Bwooce/ZebSerialWifi/enclosure/renders/diode_iso.png

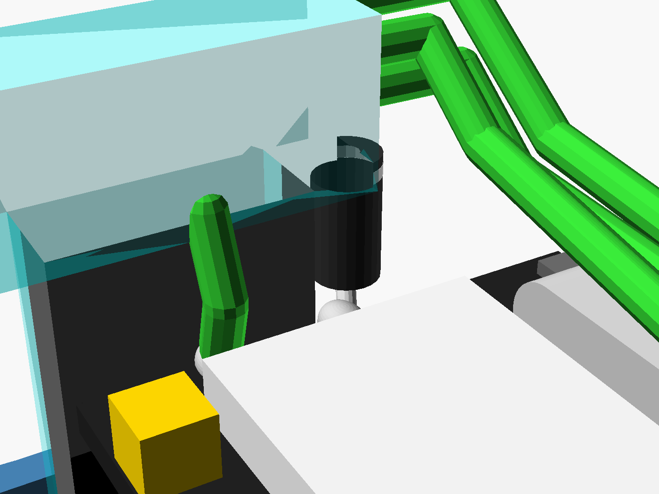
enclosure/renders/diode_iso.png
