Bwooce/ZebSerialWifi/enclosure/renders/exploded.png

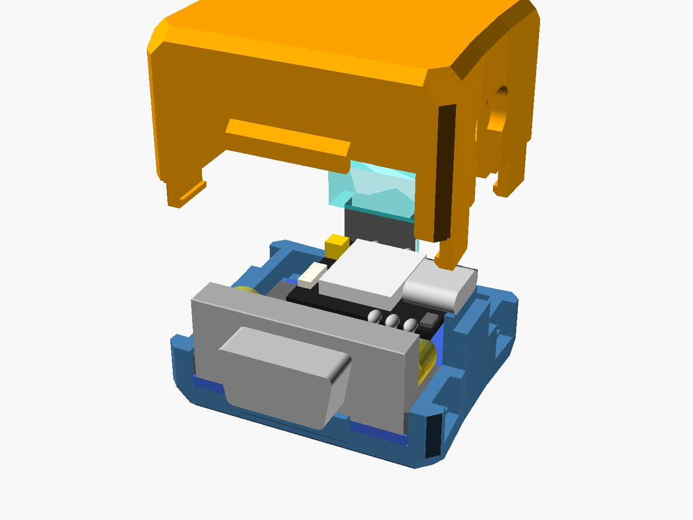
enclosure/renders/exploded.png
