Bwooce/ZebSerialWifi/enclosure/renders/front_elevation.png

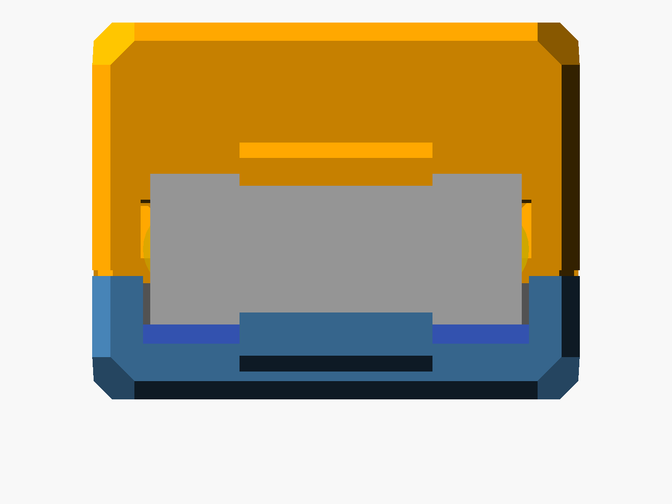
enclosure/renders/front_elevation.png
