Bwooce/ZebSerialWifi/enclosure/renders/front_flush.png

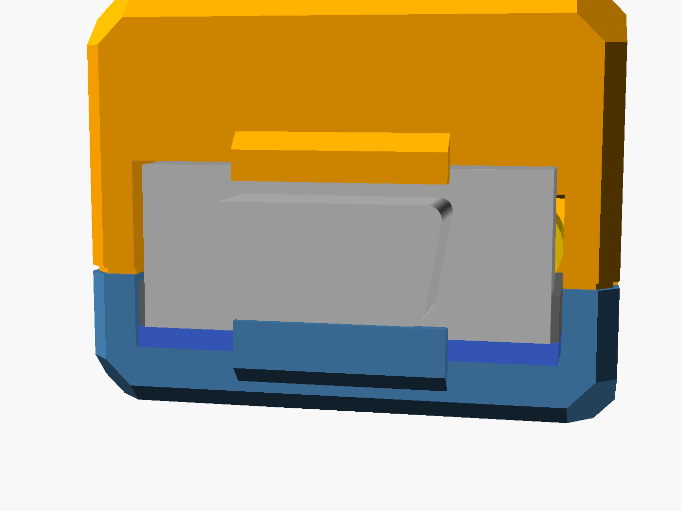
enclosure/renders/front_flush.png
