Bwooce/ZebSerialWifi/enclosure/renders/lid_front.png

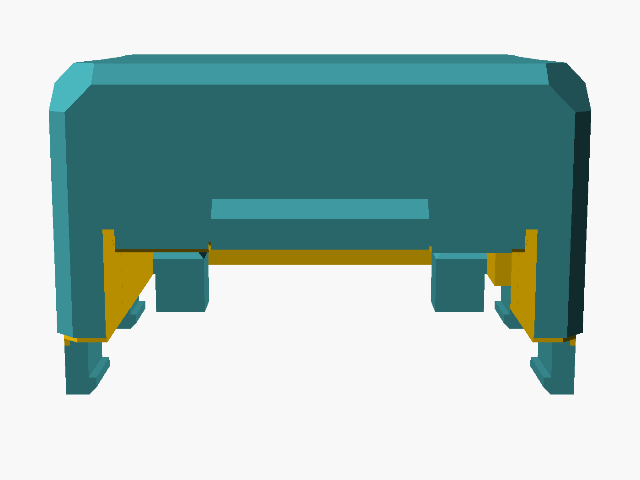
enclosure/renders/lid_front.png
