Bwooce/ZebSerialWifi/enclosure/renders/plugged_floor_deboss.png

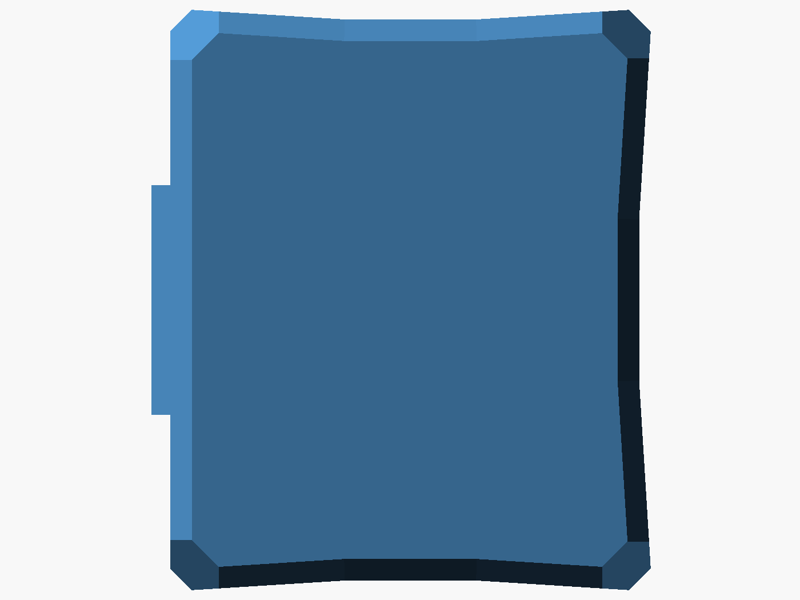
enclosure/renders/plugged_floor_deboss.png
