Bwooce/ZebSerialWifi/enclosure/renders/plugged_iso.png

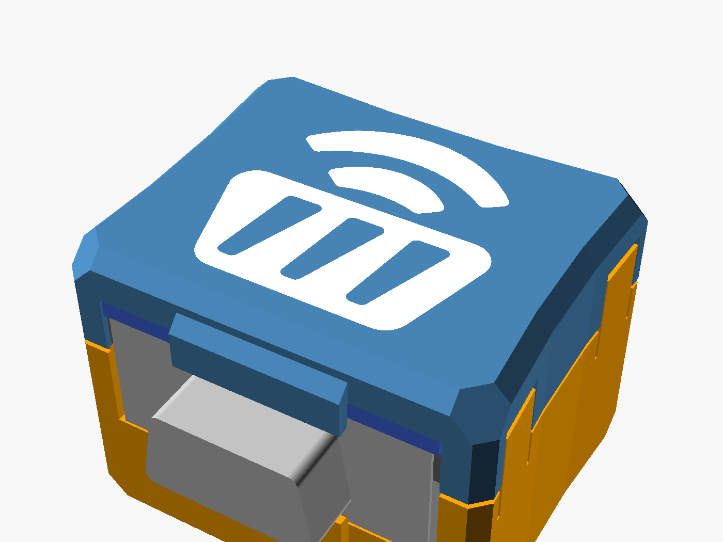
enclosure/renders/plugged_iso.png
