Bwooce/ZebSerialWifi/enclosure/renders/section_diode.png

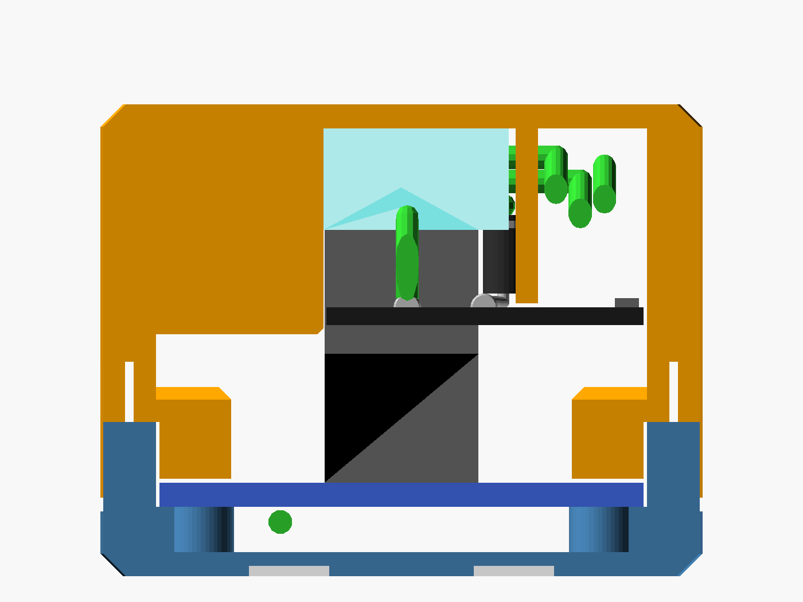
enclosure/renders/section_diode.png
