Bwooce/ZebSerialWifi/enclosure/renders/section_jack.png

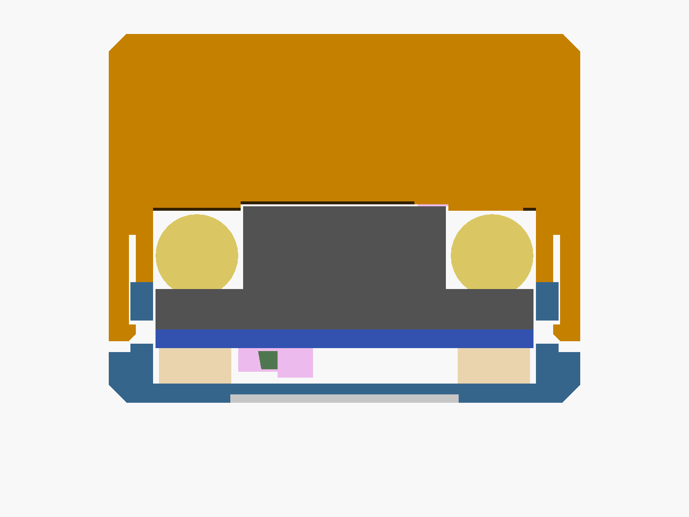
enclosure/renders/section_jack.png
