Bwooce/ZebSerialWifi/enclosure/renders/section_leg_keepout.png

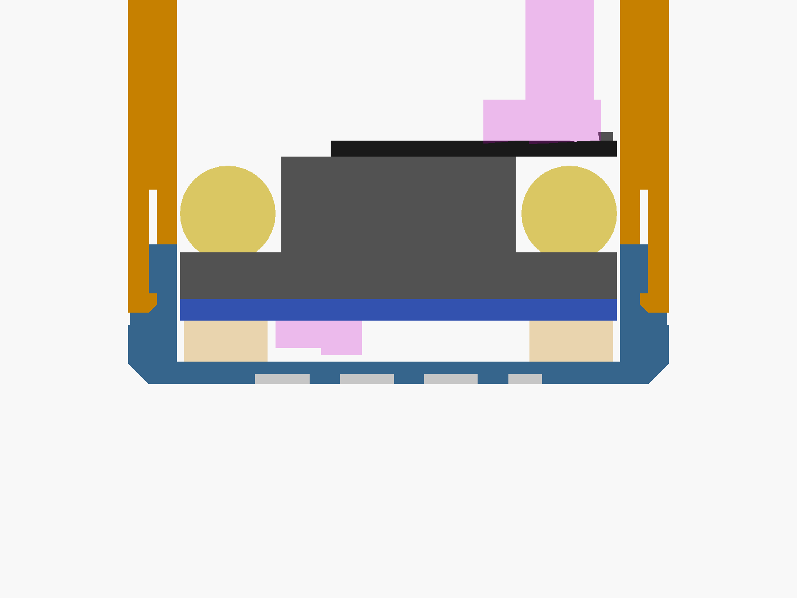
enclosure/renders/section_leg_keepout.png
