Bwooce/ZebSerialWifi/enclosure/renders/section_lips.png

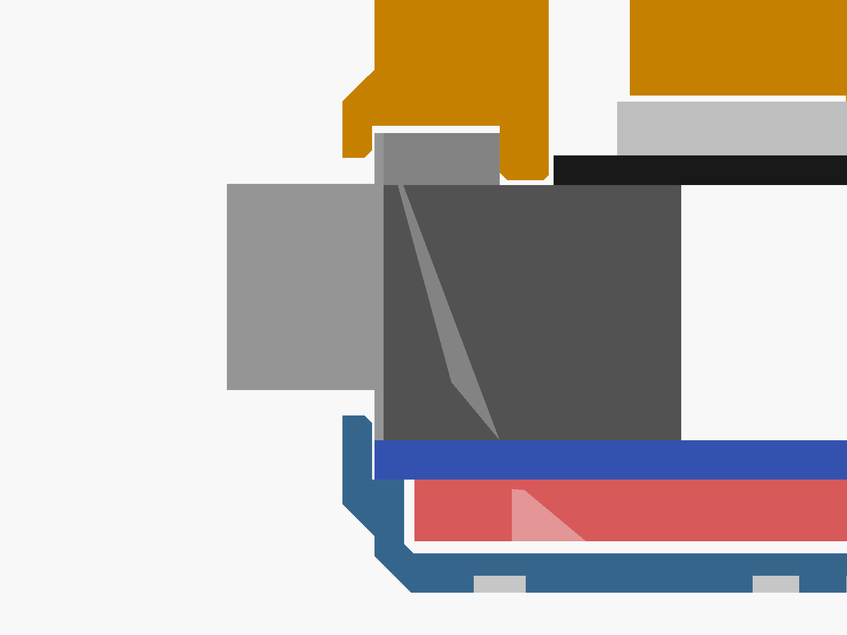
enclosure/renders/section_lips.png
