Bwooce/ZebSerialWifi/enclosure/renders/section_p9.png

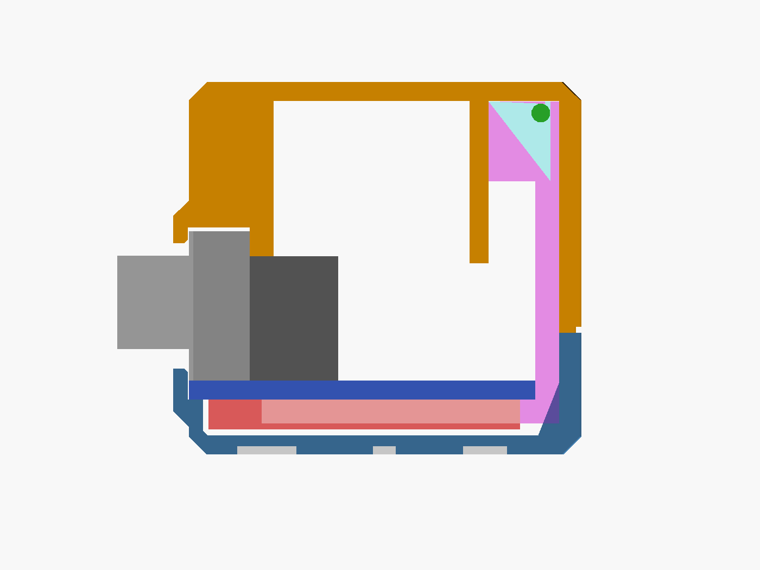
enclosure/renders/section_p9.png
