Bwooce/ZebSerialWifi/enclosure/renders/section_pin_x.png

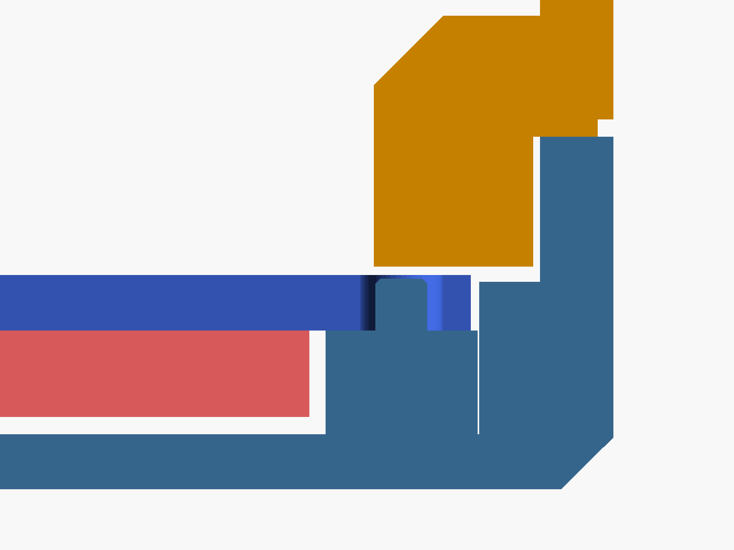
enclosure/renders/section_pin_x.png
