Bwooce/ZebSerialWifi/enclosure/renders/section_pins.png

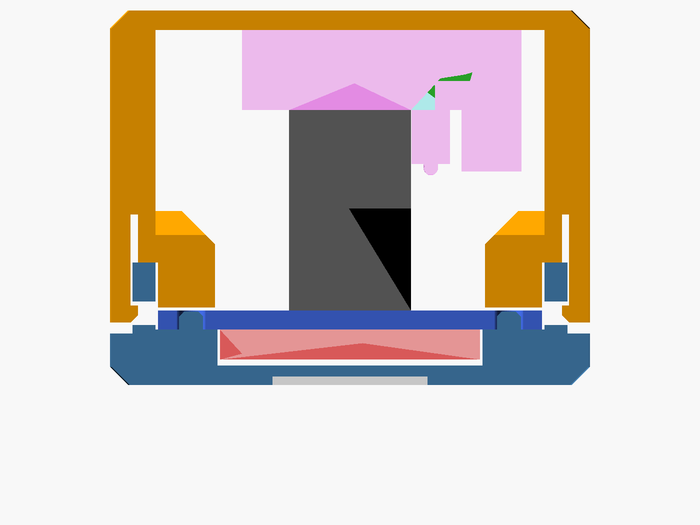
enclosure/renders/section_pins.png
