Bwooce/ZebSerialWifi/enclosure/renders/section_plan_stop.png

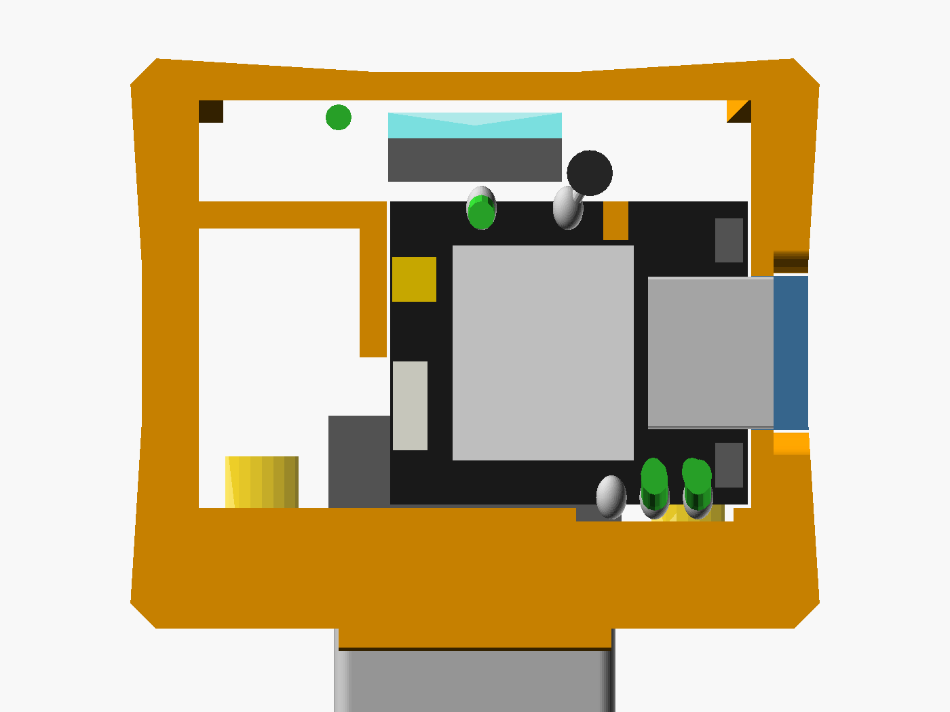
enclosure/renders/section_plan_stop.png
