Bwooce/ZebSerialWifi/enclosure/renders/section_plan_usb.png

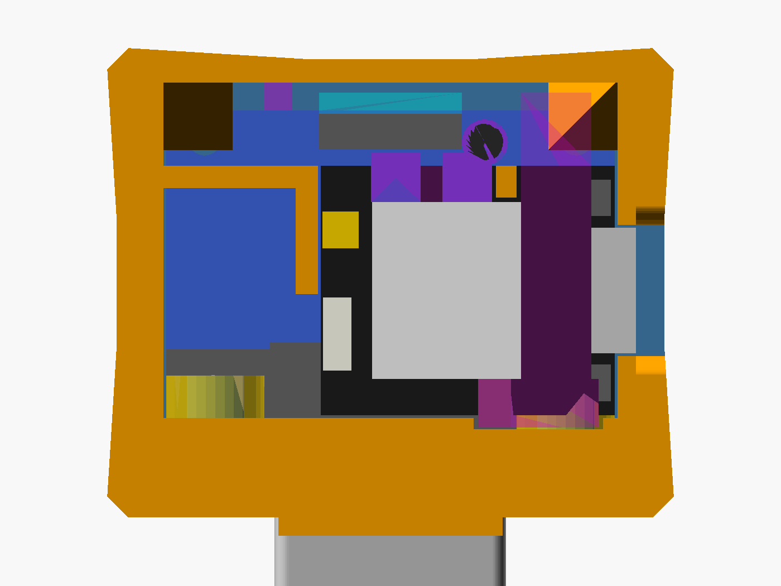
enclosure/renders/section_plan_usb.png
