Bwooce/ZebSerialWifi/enclosure/renders/section_plan_usb_case_only.png

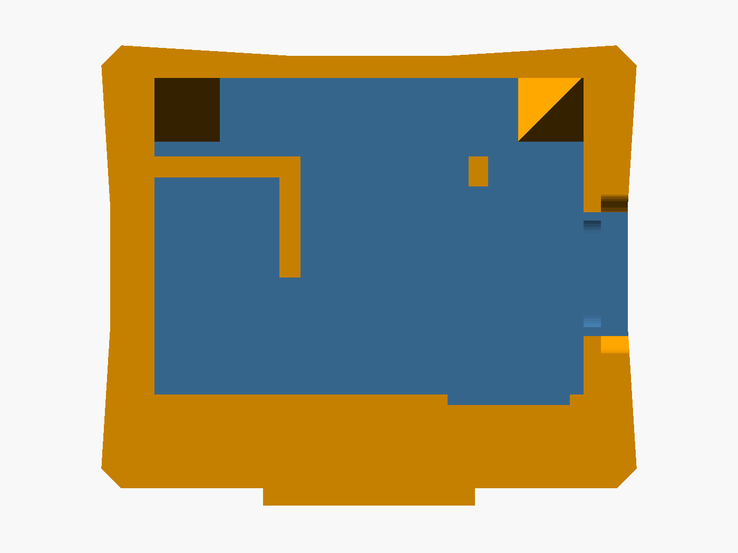
enclosure/renders/section_plan_usb_case_only.png
