Bwooce/ZebSerialWifi/enclosure/renders/section_plate.png

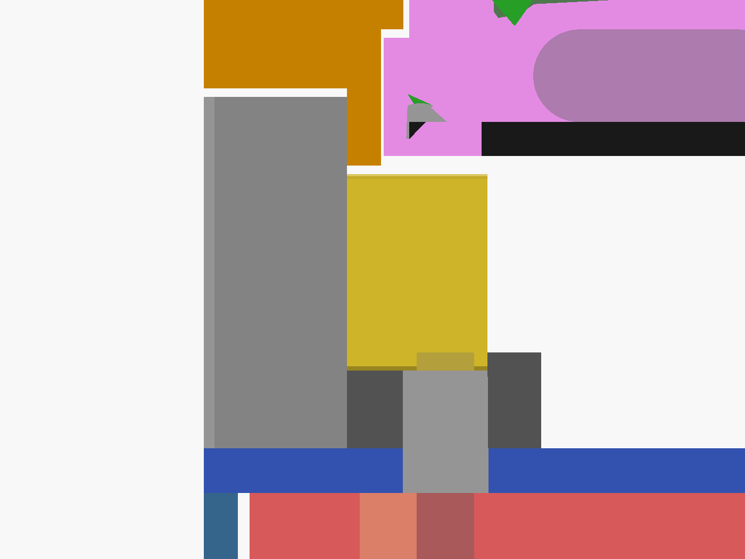
enclosure/renders/section_plate.png
