Bwooce/ZebSerialWifi/enclosure/renders/section_shield_stop.png

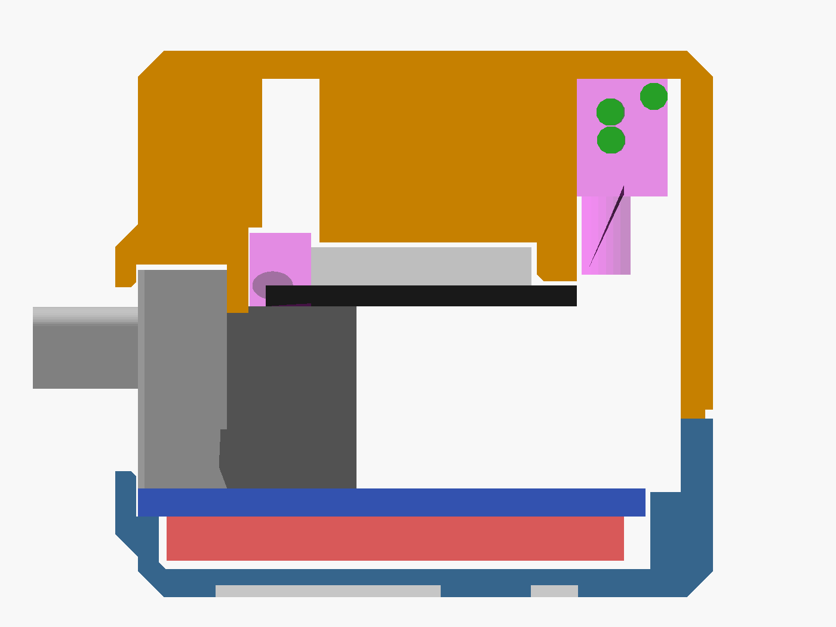
enclosure/renders/section_shield_stop.png
