Bwooce/ZebSerialWifi/enclosure/renders/section_snap_front.png

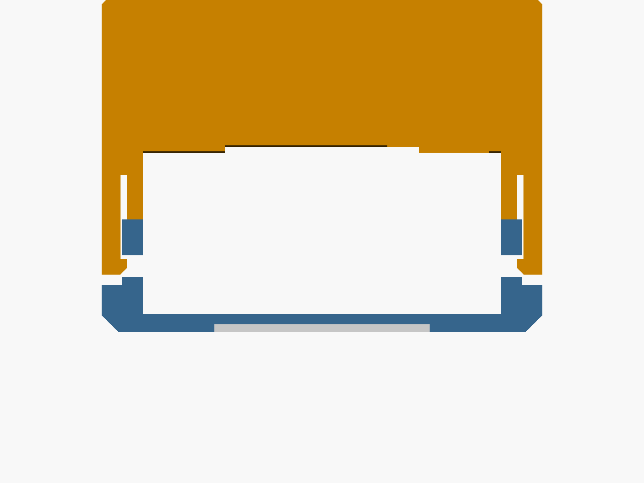
enclosure/renders/section_snap_front.png
