Bwooce/ZebSerialWifi/enclosure/renders/section_snap_rear.png

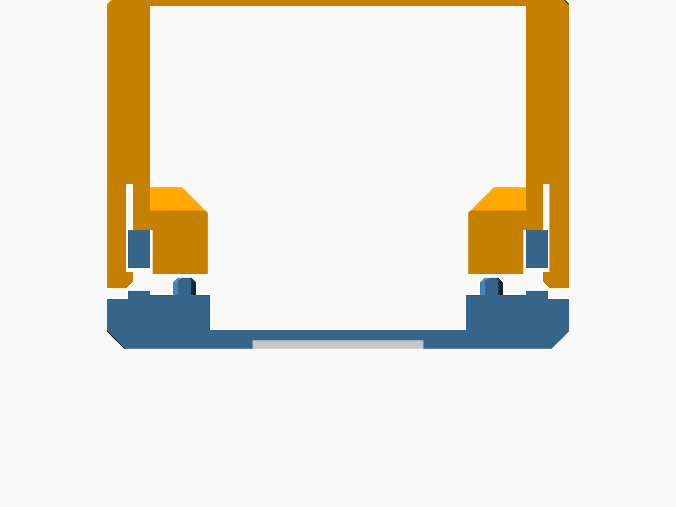
enclosure/renders/section_snap_rear.png
