Bwooce/ZebSerialWifi/enclosure/renders/section_usb.png

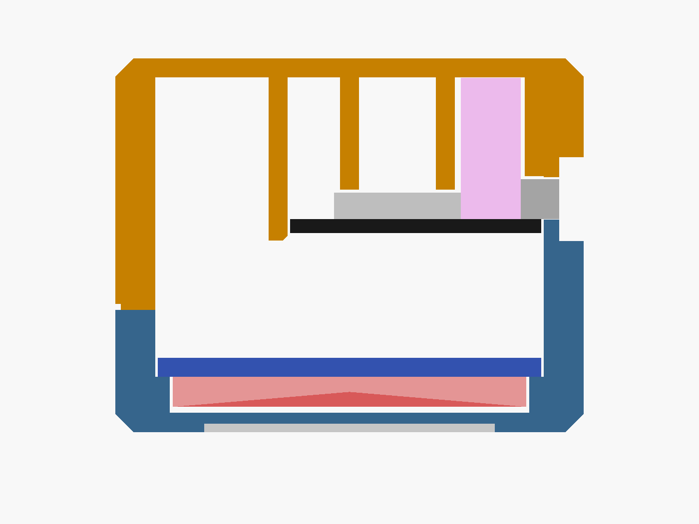
enclosure/renders/section_usb.png
