Bwooce/ZebSerialWifi/enclosure/renders/section_x0.png

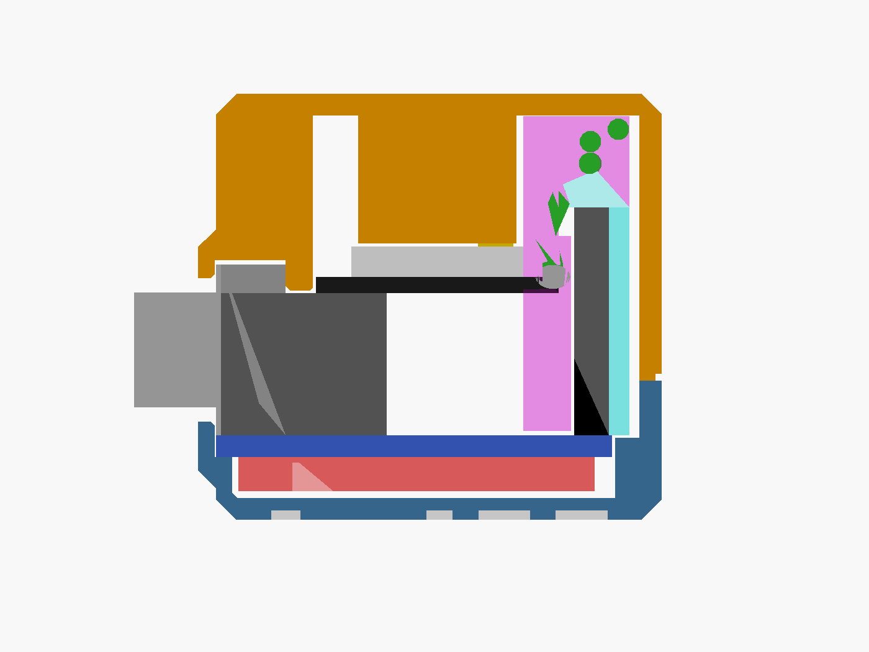
enclosure/renders/section_x0.png
