Bwooce/ZebSerialWifi/enclosure/renders/side_usb.png

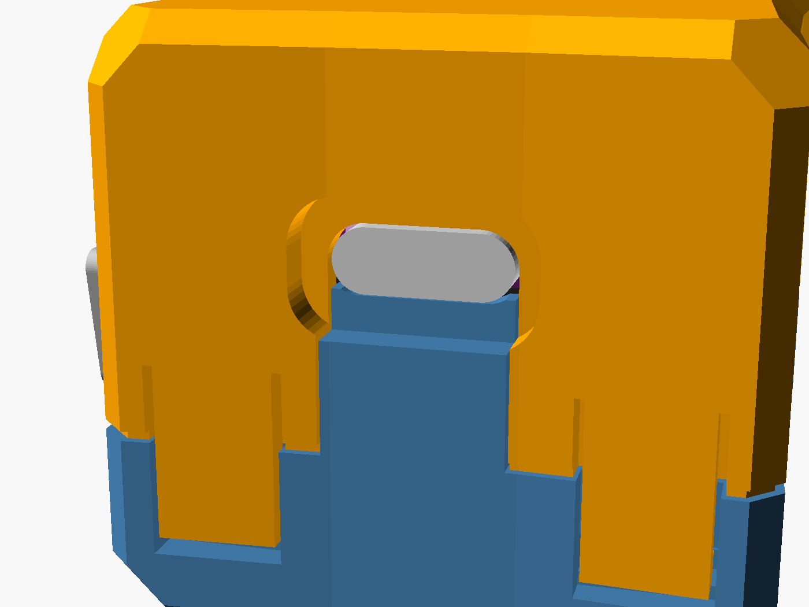
enclosure/renders/side_usb.png
