Bwooce/ZebSerialWifi/enclosure/renders/side_usb_case_only.png

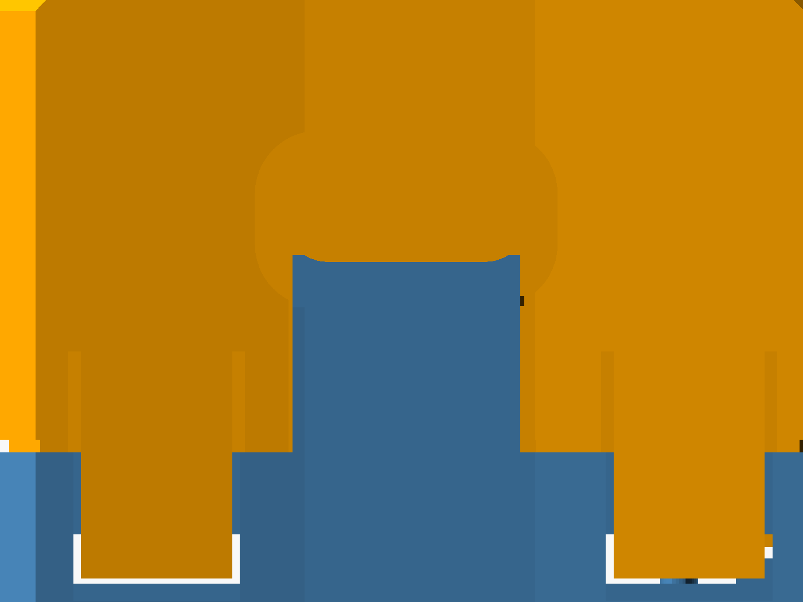
enclosure/renders/side_usb_case_only.png
