Bwooce/ZebSerialWifi/enclosure/renders/style_iso.png

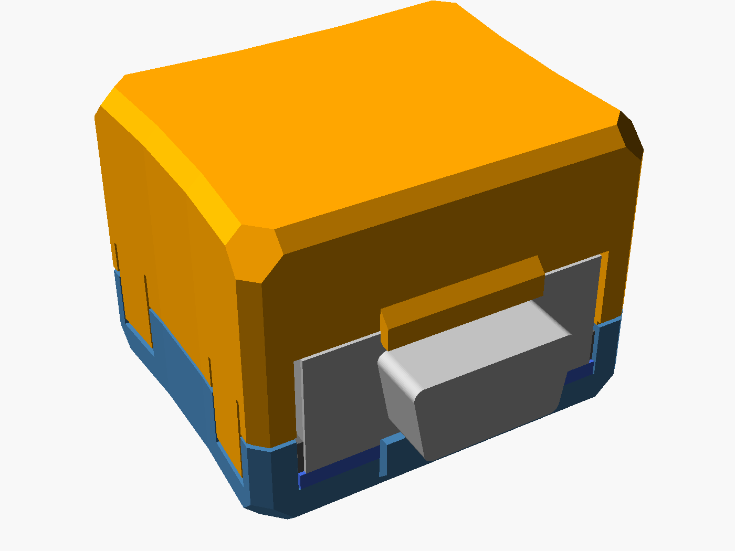
enclosure/renders/style_iso.png
