Bwooce/ZebSerialWifi/enclosure/renders/style_plan.png

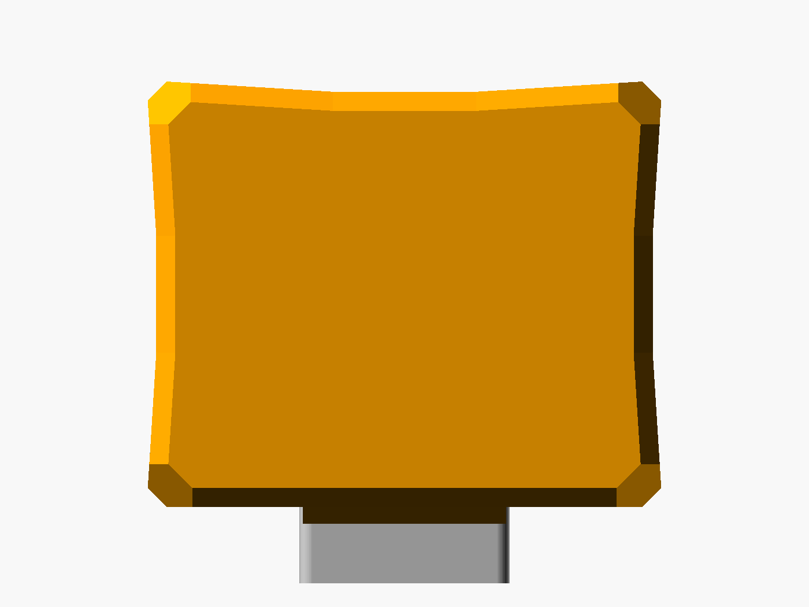
enclosure/renders/style_plan.png
