Bwooce/ZebSerialWifi/enclosure/renders/style_side.png

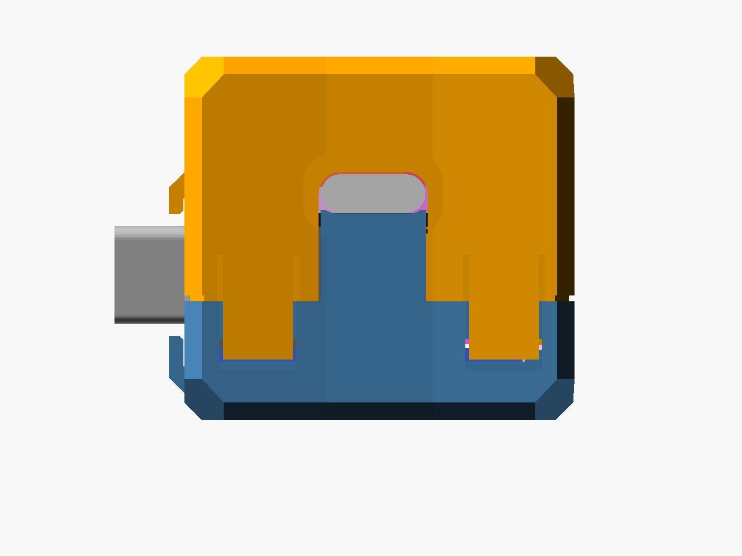
enclosure/renders/style_side.png
