Bwooce/ZebSerialWifi/enclosure/renders/xiao_lid_off.png

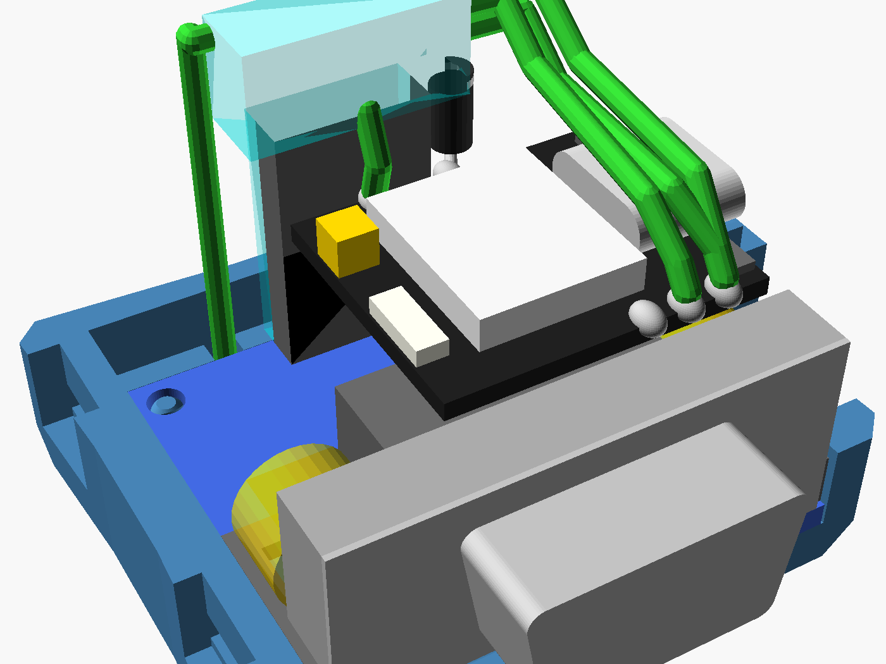
enclosure/renders/xiao_lid_off.png
