Bwooce/ZebSerialWifi/enclosure/out/tray.stl

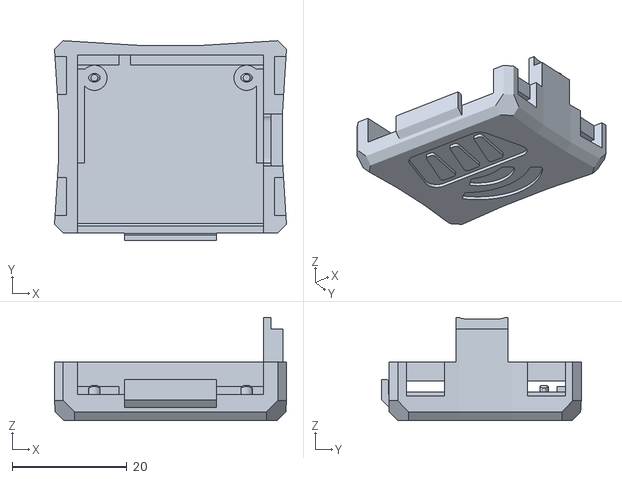
[picture p34: CAD file, 2026-10-17]
enclosure/out/tray.stl
40.4 x 34.8 x 18.0
