Bwooce/ZebSerialWifi/print/zebserial_case.3mf

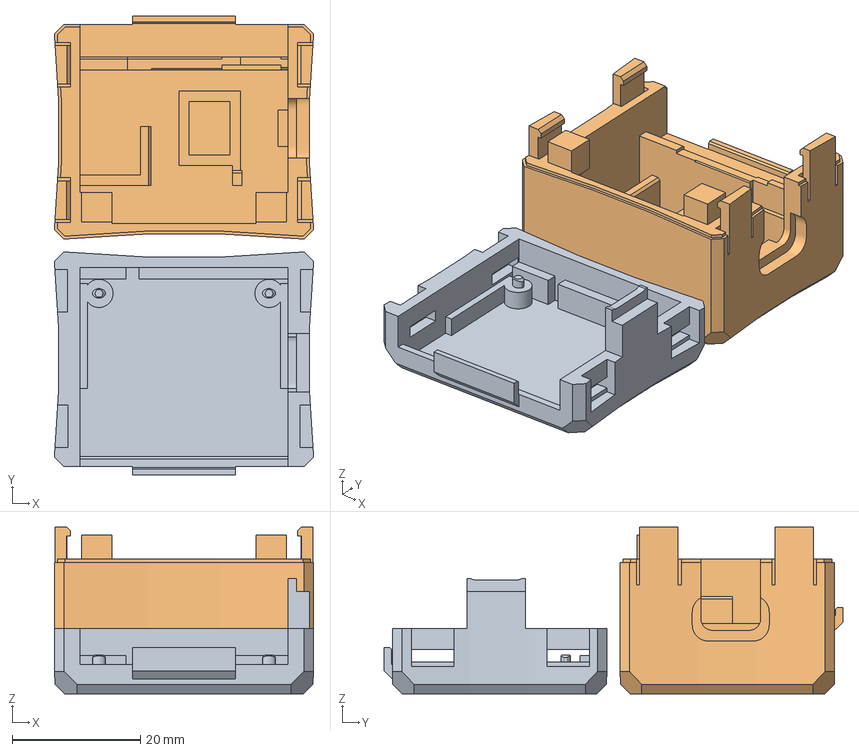
[picture p35: CAD file, 2026-10-17]
print/zebserial_case.3mf
40.4 x 71.5 x 26.0 mm
assemble_1
assemble_2
