Bwooce/ZebSerialWifi/enclosure/out/lid.stl

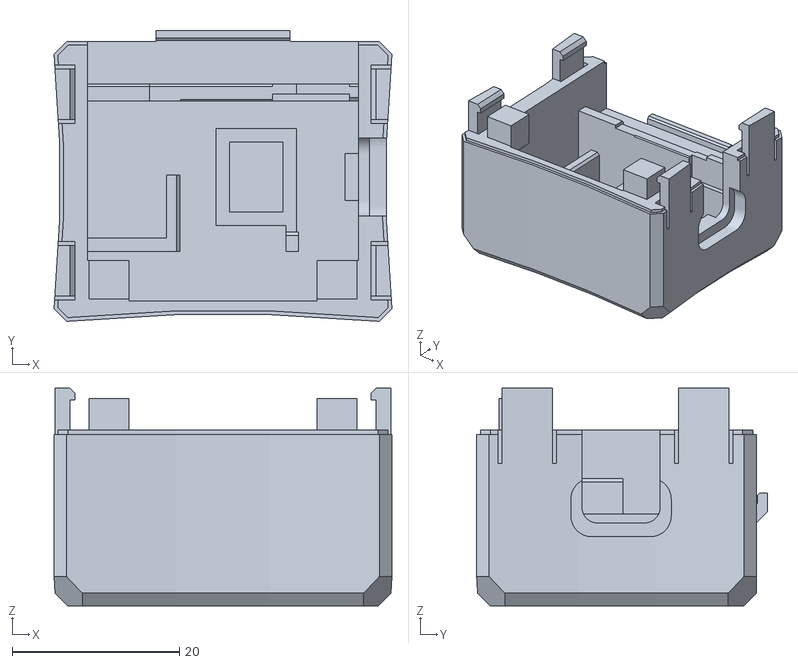
[picture p36: CAD file, 2026-10-17]
enclosure/out/lid.stl
40.4 x 34.8 x 26.0
