Bwooce/ZebSerialWifi/print/zebserial_coupon.3mf

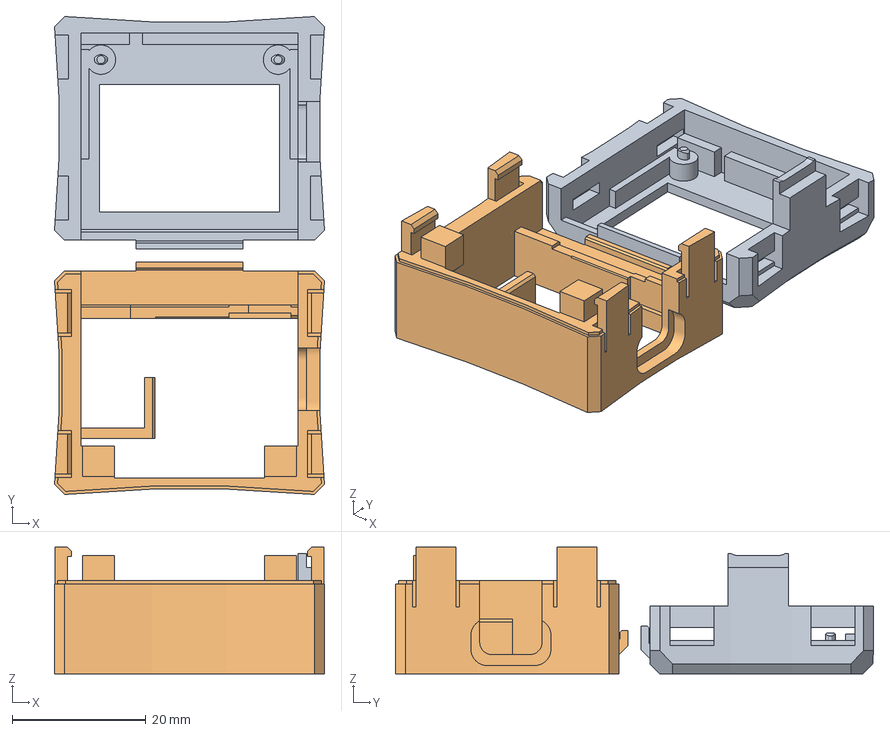
[picture p37: CAD file, 2026-10-17]
print/zebserial_coupon.3mf
40.4 x 71.5 x 19.0 mm
coupon_tray.stl
coupon_lid.stl
