Bwooce/ZebSerialWifi/enclosure/out/coupon_tray.stl

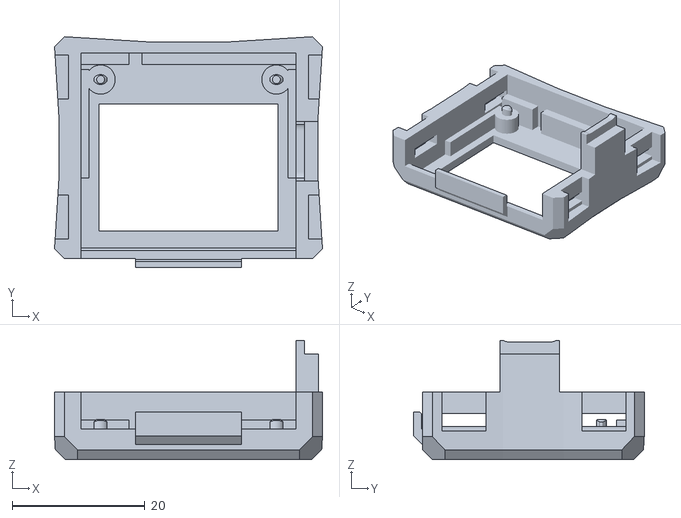
[picture p38: CAD file, 2026-10-17]
enclosure/out/coupon_tray.stl
40.4 x 34.8 x 18.0
