Bwooce/ZebSerialWifi/enclosure/out/coupon_lid.stl

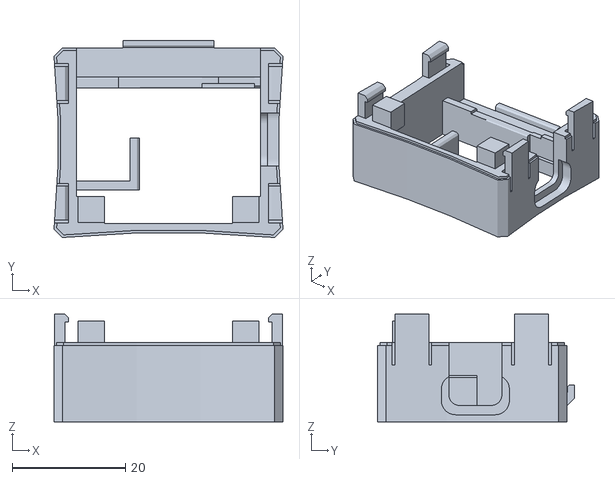
[picture p39: CAD file, 2026-10-17]
enclosure/out/coupon_lid.stl
40.4 x 34.8 x 19.0
