Bwooce/ZebSerialWifi/enclosure/out/logo.stl

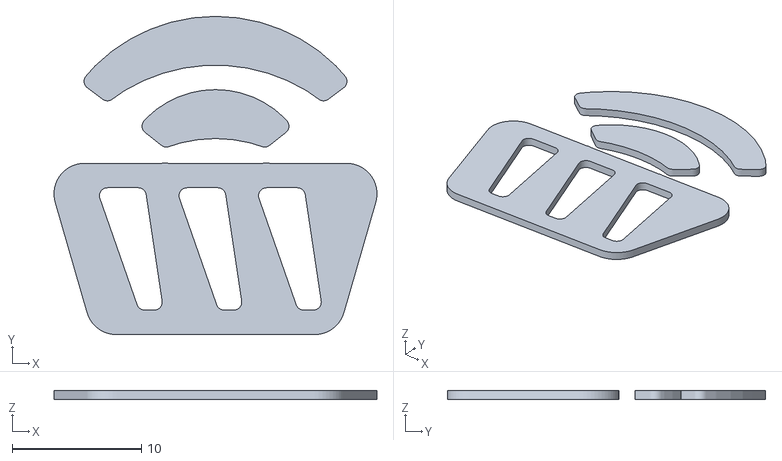
[picture p40: CAD file, 2026-10-17]
enclosure/out/logo.stl
25.0 x 24.6 x 0.68
