Bwooce/ZebSerialWifi/enclosure/renders/assembly_front.png

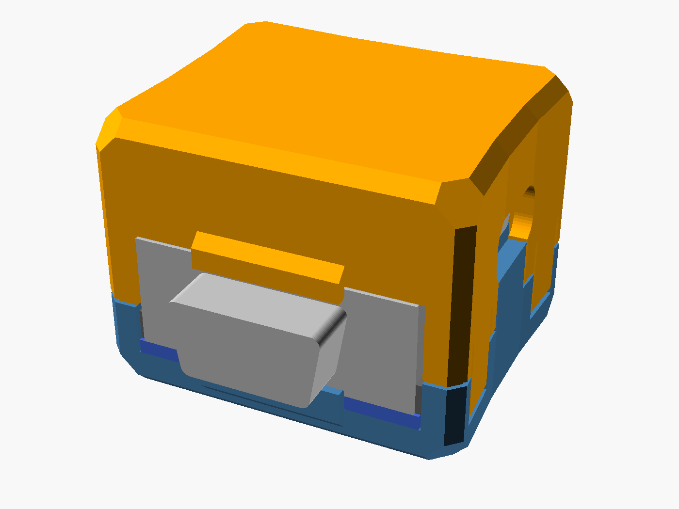
enclosure/renders/assembly_front.png
