Bwooce/ZebSerialWifi/enclosure/renders/assembly_rear.png

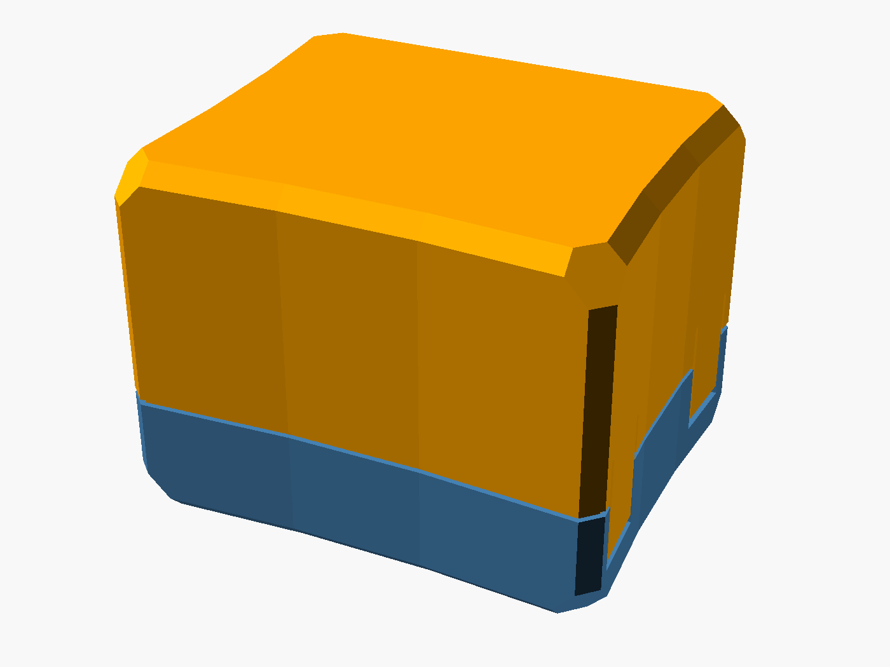
enclosure/renders/assembly_rear.png
