Bwooce/ZebSerialWifi/enclosure/renders/print_lid.png

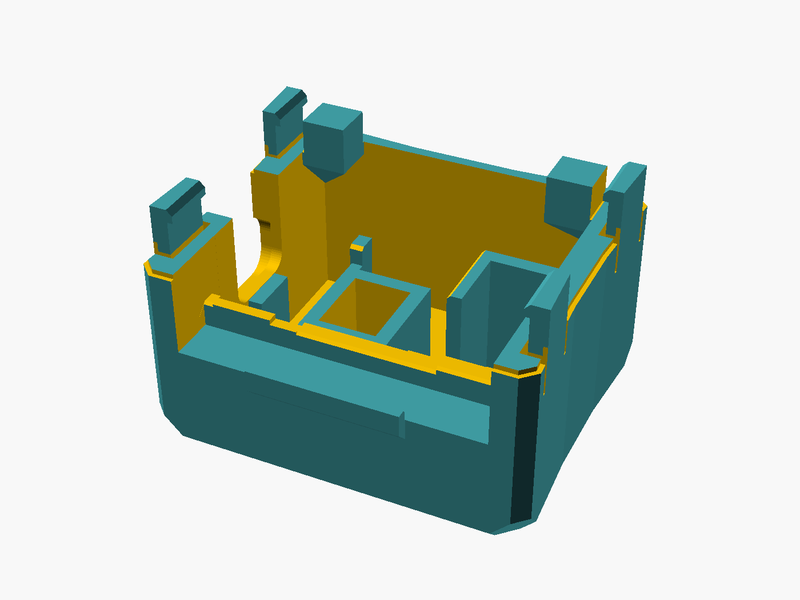
enclosure/renders/print_lid.png
