Bwooce/ZebSerialWifi/enclosure/renders/print_tray.png

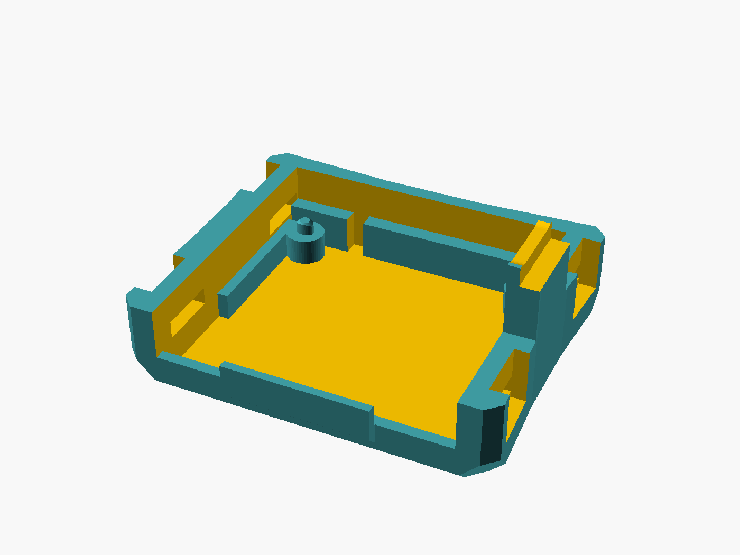
enclosure/renders/print_tray.png
