Bwooce/ZebSerialWifi/(commit log)

2026-10-07 Add design spec for WiFi-to-RS232 bridge and enclosure
2026-10-07 Add IDF project skeleton, board support and NVS settings
2026-10-07 Add printer link: baud scan, raise to 115200, XON/XOFF, ~HS polling
2026-10-07 Add TCP 9100 bridge with backpressure, stall and idle handling
    [bridge.c, bridge.h]
2026-10-07 Classify UART pins as driven or floating and scan all pads when detection fails
    [board.c]
2026-10-07 Keep last good baud on failed scan, dump unparsed replies, add SGD fallback probe
    [printer_link.c, printer_link.h]
2026-10-07 Wait out printer pauses while the client is alive; detect dead clients with keepalive
2026-10-07 Cache the setup page WiFi scan so captive-portal probes do not rescan
2026-10-07 Add parametric OpenSCAD enclosure for the RS232 board and XIAO ESP32-C6
    Tray and lid joined by flush cantilever snaps, lid sockets locate on the DB9
    flange hardware, XIAO held in the lid by offset C-clips clear of the used pads
    with a front stop against USB insertion force. Includes STLs, renders, a build
    script with ghost/part interference checks, and a fit-check list of the
    unmeasured dimensions.
    [lid.stl, tray.stl, zebserial_case.scad]
2026-10-07 Make the XIAO front stops compression struts from the lid front wall
    Thin hanging tabs would take the USB insertion load in bending across the
    layer lines; struts carry it straight into the front wall and the DB9
    hardware sockets.
    [lid.stl, zebserial_case.scad]
2026-10-07 Fix tray print orientation in spec; ignore local .claude state
2026-10-07 Add runtime options: idle timeout, target printer baud, UART pin mode
2026-10-07 Configure printer baud and XON/XOFF with ZPL ^SC; read handshake via SGD or ^HH
2026-10-07 Target the GK430t (300 dpi) and record printer configuration changes in the spec
2026-10-07 Show the logo on the web pages, serve it as the favicon, compact uptime
    The mark is inlined in the setup and status page headings with currentColor
    so it follows the light/dark text colour. GET /favicon.svg is a registered
    route, so the captive-portal 404 redirect does not catch it. Uptime now
    reads 2d 3h 14m, 3h 14m or 14m.
2026-10-07 Deboss the logo into the lid top
    22 mm wide, 0.5 mm deep (logo_w, logo_depth, show_logo), centred and upright
    seen from above with the DB9 at the bottom edge. 1.73 mm of the 2.23 mm top
    skin remains under it; the model asserts at least 1.0 mm. Interference
    checks unchanged; new render renders/lid_top_logo.png.
    [lid.stl, zebserial_case.scad]
2026-10-07 Add settings page: printer baud, UART pins, idle timeout, hostname, static IPv4; show IPv6
2026-10-07 Add Bambu Studio CLI slicing setup for the case (H2D, PETG, textured PEI)
2026-10-07 Restyle the case exterior as a faceted pincushion
    Concave three-facet side and rear faces (2 % sag), 2.8 mm vertical corner
    chamfers, 1.5 mm 45-degree top and bottom edge chamfers and a seam reveal,
    cut from one outer solid for both halves. Top, bottom and the DB9 datum face
    stay flat. Side walls go to 4.0 mm and snap geometry is measured from the
    deepest point of each bowed face; catches become through-windows so no
    wall drops under 1.2 mm.
    Add wallprobe.py (ray-cast wall thickness) to build.sh. It found and this
    fixes thin webs between board-clip slots and snap pockets, a socket cusp,
    0.5 mm over the USB relief (lid now 1.6 mm taller), a strut-tip sliver at
    xiao_overhang 3 and seam-groove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
    [lid.stl, tray.stl, zebserial_case.scad]
2026-10-07 Match the reference's corner truncations and keep XIAO clip flex length
    Corners are now cut by planes square to the body diagonal (5 mm facets)
    with a small 1.5 mm vertical bevel, as on the Radar360 reference when
    rendered from the same cameras. XIAO C-clips hang from a rigid root down
    to the old ceiling height so the taller lid does not soften them. The
    stop-strut lip is kept down to 0.8 mm and an ECHO note reports when it is
    dropped (xiao_overhang below about 3.7); README corrected to match.
    [lid.stl, tray.stl, zebserial_case.scad]
2026-10-07 Add sliced Bambu Studio project for the restyled case (66 min, 15.9 g PETG)
    [zebserial_case.3mf]
2026-10-07 Use manufacturer DB9 and XIAO dimensions and rework the XIAO mount
    DB9 from Norcomp/Connfly/PDI drawings: flange 0.38 thick and seated on the
    PCB (holes 6.25 up), rear body to 12.42 from the face, 11.1 tall, optional
    12.2 step; hex-nut socket option. XIAO from Seeed's KiCad PCB and STEP:
    20.955 x 17.78, pad 1 at 2.921, real antenna, U.FL, button and shield
    positions, GCT USB4105 shell. New pcb_front_y and xiao_front_from_flange.
    The XIAO now rests on the DB9 body (3 mm overlap at the new default
    overhang of 2), on a tray tongue 0.05 mm under the USB shell, and is held
    by long side clamps (ledge under, lip over) on the unused-pad stretches,
    with a D6 front rest added when the body overlap is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
    [lid.stl, tray.stl, zebserial_case.scad]
2026-10-07 Guard a full-width DB9 body, fix the rear snap section and correct README claims
    A body wider than the hardware spacing now merges the sockets into the body
    notch and drops the stop plates instead of leaving 0.35 mm slivers. The
    rear snap section follows the snap's new Y. README: the case is only
    located forwards on the connector (rearward is a known gap), the XIAO
    height chain is tighter than body_h and xiao_pcb_t are known, and those
    two measurements are print-blocking.
    [zebserial_case.scad]
2026-10-07 Re-fit the case to the user's caliper measurements and pin it to the DB9 lugs
    RS232 PCB 26.0 deep x 1.6, flush with the flange front; DB9 body 17.2 x
    10.4 with 3.4 mm lugs either side; XIAO PCB 1.2, USB-C 3.3, shield 2.2.
    The jackscrew sockets are replaced by two flatted lid pins that drop into
    the lug screw holes and finally stop the case sliding rearwards off the
    connector (friction-only ECHO when lug_pin_on is off).
    The XIAO is placed by xiao_front_y = 9.1: 3.3 mm on the DB9 body with the
    D4/D5 underside joint zone clear of it. Wire keep-out zones under the
    XIAO and to the header are now part of the interference check. Positive
    controls cover the pins, the zones, the tongue and the clamp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
    [lid.stl, tray.stl, zebserial_case.scad]
2026-10-07 Drop the lug pins, rest the XIAO 2.0 mm on the DB9 body, add leg-tail pockets
    The lug holes are filled by soldered board-lock legs, so lug_pin_on is now
    off (code kept). The XIAO is placed by xiao_rest = 2.0 on the body (front
    Y 10.42), giving more room for the wires under it; the body is the active
    front support. New leg_pocket_on option (default off until measured):
    tray-floor bosses with lead-in pockets around the board-lock leg tails lock
    the board fore-aft both ways, with a floor-breach warning. With it off the
    model ECHOs friction only.
    [lid.stl, tray.stl, zebserial_case.scad]
2026-10-07 Apply the final measurements: round 3.1 mm leg tails, body end 12.5, lugs to 12.0
    Leg pockets are now on by default: slotted pockets (0.3 mm in Y, +-1 mm
    extra in X for the unmeasured leg X) in bosses around the tails, whose tips
    reach the floor top; 1.3 mm of floor stays under each pocket. The XIAO
    re-derives to Y 10.5 for the 2.0 mm rest. Because the lugs now run to
    Y 12.0, the board clips move behind them (13.9 both sides, 20.5 on +X),
    the front lid snap moves to Y 7 and its fingers shorten so the catch
    windows clear the bosses; the -X presser is dropped.
    [lid.stl, tray.stl, zebserial_case.scad]
2026-10-07 Set the measured board-lock leg spacing (24.9 mm, lug_hole_x 12.45)
    The measurement is approximate, so the leg-tail slots keep their +-1 mm
    extra in X; lug_hole_x leaves the open fit-check items.
    [tray.stl, zebserial_case.scad]
2026-10-07 Re-slice the print project for the measured case (62 min, 15.5 g PETG)
    [zebserial_case.3mf]
2026-10-08 Act on the firmware code review: SGD echo, pin probe, stats and restart races
    - zpl_sgd_value skips lines starting with '!', so a loopback plug echoing
    our getvar no longer counts as a printer reply (host tests added; they
    fail against the old parser). sgd_get logs when the line echoes.
    - UART pin detection holds the other pin pulled up while probing, so a
    looped or echoing line keeps R1OUT at idle high.
    - Bridge discards stale probe replies before serving a client.
    - 64-bit byte counters and bridge stats are updated and copied under a
    spinlock, so the status page never reads a torn value.
    - The captive DNS task now lives for good and sleeps between stop and
    start, closing a stop/s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
    [board.c, bridge.c, dns_hijack.c, printer_link.c, printer_link.h, web.c, wifi_prov.c]
2026-10-08 Rework the case from the first test print: flush flange, lips, rigid captures
    The leg-tail pockets sat at the lug screw hole (Y 4.6) but the spikes are at
    Y 8.9, so the board sat 4.3 mm forward: flange proud of the case, XIAO off
    the DB9 body. Changes:
    - Case front face at Y 0, flush with the flange front; the lid front wall
    behind the flange is the bearing face. y_cf (case front) and y_fb (flange
    back) are now separate.
    - Top (lid) and bottom (tray) retention lips over the flange margins, |X| <= 8,
    1.3 proud, 0.1 gap, clear of the D-shell and jackposts; they also hold the
    loose shield.
    - Leg pockets at leg_y 8.9, loose in Y (0.6 per side); ledges start behind
    the bosses.
    - Rigid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
    [lid.stl, tray.stl, zebserial_case.scad]
2026-10-08 Document revision 2 of the enclosure: flush flange, lips, rigid captures, controls
2026-10-08 Correct the Step 0 note, list the overhang probe result and the leg-tail reference question
2026-10-08 Add a bold lid variant of the logo mark: two wide stripes, round-capped arcs, 1.2 mm minimum features at 30 mm
2026-10-08 Two-colour logo inlay, Dupont keep-out and fit coupons
    - Logo: bold lid mark at 30 mm, flush two-colour inlay by default
    (part="logo" -> out/logo.stl, same coordinates as lid.stl, cut from the
    lid with no clearance), 0.6 mm deboss fallback (logo_mode), and
    part="check_logo" proving every stroke and gap >= 1.2 mm.
    - Dupont housing on the RS232 header (dupont_top 14.5) plus a wire-bend
    zone to the XIAO edge and the ceiling: new ghost, in all interference
    checks; the -X XIAO guide is cut back to d 2.2..5.16; the ceiling keeps
    dupont_bend_h 4.0 above the housing (top 20.1 above the board).
    - Fit coupons: part="coupon_tray" / "coupon_lid", the front 14.5 mm,
    exported to out/.
    - cont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
    [coupon_lid.stl, coupon_tray.stl, lid.stl, logo.stl, tray.stl, zebserial_case.scad]
2026-10-08 Add the sliced fit coupon print project (front 14.5 mm of tray and lid, 36 min, 6.9 g PETG)
    [zebserial_coupon.3mf]
2026-10-08 Apply the user's measurements: spikes at 9.5, Dupont top 16.7 and 23.4 ceiling
    - leg_y 9.5 (leg-tail centres, calipers); ledges now start at Y 13.45.
    - dupont_top 16.7 (18.3 above the PCB underside) and new dupont_ceiling_min
    23.4 (25 mm wire turning space from the underside): the top is now 25.0
    above the PCB top, exactly max_above. Skin under the logo stays 1.0.
    - pcb_rear_keepout 3.0: resistors near the RS232 rear edge; the +X presser
    moves from Y 24 to 21, and a keep-out ghost plus a control enforce it.
    - Rebuilt STLs (including logo and coupons) and renders.
    [coupon_lid.stl, coupon_tray.stl, lid.stl, tray.stl, zebserial_case.scad]
2026-10-08 Slice the revised case in two colours (logo inlay on filament 2) and re-slice the fit coupon
    run_slice.sh takes a case|coupon mode. The case uses an assemble list so the
    logo is a part of the lid object on the second filament; the second filament
    needs its own preset name and colour or the CLI crashes. Case 1 h 22 min,
    20.4 g + 0.4 g; coupon 43 min, 8.3 g.
    [zebserial_case.3mf, zebserial_coupon.3mf]
2026-10-10 Take the bench agent's link changes, reworked: echo-gated XON/XOFF, safe loopback probe
    - XON/XOFF stays on for a real printer whether or not it has been detected;
    it is switched off only once the line is seen echoing our own commands (a
    loopback plug, where our XOFF would pause our own transmitter), and back
    on when a printer answers. uart_setup applies the same state, so an abort
    (driver reinstall) no longer drops flow control.
    - RX pin pulled up, so it idles at mark if the module is unpowered.
    - Active loopback pin probe runs only when the passive probe finds both
    pins floating, and so never drives against the MAX3232's R1OUT.
    - Drain the queued job to the printer even after the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
    [board.c, bridge.c, printer_link.c]
2026-10-10 Model the flange screw-hole hardware and pocket the lid around it
    The threaded hardware behind each flange screw hole (X +-12.5, z 6.25,
    flange back to Y 5.1) was not modelled, and the lid front wall ran through
    it. New ghost (hw_d 5.6 round envelope, hw_sides for a hex) in every check;
    lid pockets with hw_clr 0.3, open to the rim and run up the body cut's side
    (no sliver), same pocket in the tray. The flange still bears on the lid
    front wall: 73 of 126 mm2 remain, all on the upper margin. Controls: a
    pocket shrunk by 0.5 hits (lid and closing path), a hex of the same size
    is clear. New renders section_hw and section_hw_front.
    [coupon_lid.stl, coupon_tray.stl, lid.stl, tray.stl, zebserial_case.scad]
2026-10-10 Open the lid for the full flange plate and bear on its back at Y 5.1
    The connector's front plate keeps the full flange outline back to 5.1 mm
    behind the flange front (the user's first measurement), but the lid front
    wall sat at Y 0.38..3.58, cut only for the DB9 body. Replaces the
    screw-hole hardware pockets of 7e6aada:
    - New fl_plate_d 5.1 and a plate ghost (full flange outline, flange back
    to fl_plate_d) in every check; hw_* parameters and pockets removed.
    - Lid open across the full interior width up to the flange slot ceiling
    and back to Y 5.1, like the tray; the front wall (Y 5.1..8.3) bears on
    the plate back, with its lead-in; the face above the flange still fills
    to Y 0 and ca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
    [coupon_lid.stl, coupon_tray.stl, lid.stl, tray.stl, zebserial_case.scad]
2026-10-10 Re-slice for the full-flange lid opening (case 1 h 25 min, 20.5 g + 0.4 g; coupon 44 min, 8.5 g)
    [zebserial_case.3mf, zebserial_coupon.3mf]
2026-10-10 Keep the RX pull-up when the UART pins change at runtime
    The Schottky level shift on RX (module at 5 V) relies on the pull-up for the
    high level; printer_link_set_pins dropped it after gpio_reset_pin.
2026-10-11 Parse ~HS flags numerically; add JSON escape and Origin check helpers
    A ~HS flag of "00" read as true. Flags now go through number(), which
    also refuses fields too long for an int. json_escape and
    url_origin_matches_host are pure functions for the web server, with host
    tests (140 checks).
    [urlcodec.c, urlcodec.h, zpl_status.c]
2026-10-11 Lock the setup AP to setup, guard POSTs against CSRF, escape status output
    Requests that arrive on the SoftAP (local address is the AP's) get only
    the setup page, /save, the favicon and the captive redirect; /settings,
    /config, /forget, /redetect and /api/status redirect to the setup page.
    wifi_prov_sock_on_ap() handles dual-stack v4-mapped addresses and fails
    closed while the AP is up.
    State-changing POSTs are refused (403) when Origin, or Referer without
    Origin, names a different host than the Host header; requests with
    neither still pass, and the captive /save post matches its own host.
    The status table escapes every value before it goes into innerHTML, and
    status JSON escapes the SSID,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
    [settings.c, settings.h, web.c, wifi_prov.c, wifi_prov.h]
2026-10-11 Drain every job before releasing the printer link; fix TX idle check
    serve() exits on recv error, failed send and idle timeout now go through
    the drain (no pumping once the client is gone, bounded by the 30 min
    stall limit, then abort), so no job tail is left queued for the link
    task. printer_link_tx_idle() also requires the driver TX ring to be
    empty; uart_wait_tx_done(0) saw only the hardware FIFO. set_baud()
    waits for that, and discards queued TX with a warning if it does not
    drain in 2 s, instead of sending it at the new rate. The link task skips
    its ~HS poll while TX is queued (XOFF held) without counting a miss.
    Bridge refuses 9100 connections that arrive on the setup AP. The link
    acq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
    [bridge.c, main.c, printer_link.c]
2026-10-11 Pull the loopback sense pin up so it works behind the RX diode
    With RX behind a Schottky (anode on the pin, cathode to R1OUT) the
    module can only pull the pin low; a pull-down read low whatever the
    line did. The inconclusive-detection warning now names a loopback plug
    or the settings page for diode-isolated RX.
2026-10-11 Free the snap fingers, open the latch window and make the gates fail on errors
    Snaps: the lid-wall slot is now 0.6 mm behind each finger (lc_slot_back) instead
    of 0.15, so PETG cannot weld the finger to the wall and cut its free length from
    9 to 5 mm; the wall behind stays 1.42 / 1.36 mm. Hook 0.75 -> 0.6 (0.45 mm
    engagement and deflection, about 1.2 % strain). The catch window top is 0.35
    above the hook top (lc_win_up, was 0.1), so the snaps engage with the lid held
    up to 0.35 high; pad and presser gaps open from 0.1 to 0.25 (xpad_gap, press_gap).
    -X ledge: a 0.6 mm strip (hdr_ledge_keep) stays along the full length beside the
    header pins, so the board edge is carried when the Dupont plug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
    [coupon_lid.stl, coupon_tray.stl, lid.stl, logo.stl, tray.stl, zebserial_case.scad]
2026-10-11 Re-slice for the snap and latch fixes and the 0.68 mm logo (case 1 h 25 min, 20.5 g + 0.37 g; coupon 44 min, 8.5 g)
    [zebserial_case.3mf, zebserial_coupon.3mf]
2026-10-11 Correct the fit-coupon wall-probe note (ledge stubs at the cut, new hook figures)
2026-10-11 Move RX to D3 behind the level-shift diode; swap pins if no printer answers
    With the module at 5 V, its T1IN pull-up drives D5 high while RX floats
    behind the diode, which the passive probe read as RX on D5. One pin high
    and one floating is now treated as ambiguous: use the defaults (TX D5,
    RX D3) and let detection try the swapped pins when no printer answers.
    [board.c, main.c, printer_link.c, printer_link.h, settings.h, web.c]
2026-10-14 Address code review findings: flow control, baud fallback, rebinding guard, socket limits
2026-10-16 Don't save an unconfirmed baud after a failed ^SC revert
    Only a baud the printer has answered at goes to NVS; detect() saves it
    once a rescan finds the printer. Saving new_baud here made the fallback
    rate for jobs one the printer never confirmed.
    [printer_link.c]
2026-10-16 Read the printer's handshake from the ~HS a7 bit
    The GX430t (V56.17.16Z) answers SGD comm.handshake with "?", which was
    taken as a non-XON/XOFF handshake, so ^SC ... ^JUS was resent on every
    boot. ~HS string 1 field aaa carries the handshake in bit a7 (0 =
    XON/XOFF, 1 = DTR) on every ZPL printer; use it when this detection got
    a ~HS reply, and treat an SGD "?" as unknown. Test fixture is a real
    GX430t reply captured on the bench.
    [printer_link.c, zpl_status.c, zpl_status.h]
2026-10-16 Keep passing printer replies to a half-closed client
    After the FIN, lwIP fails MSG_PEEK reads with ENOTCONN, so client_alive()
    called a half-closed client gone and the drain loop threw the printer's
    replies away: an immediate send-then-shutdown ~HS over 9100 got 0 bytes
    while the UART had received all 82. ENOTCONN now counts as alive; a peer
    that has really gone still shows up as a failed send.
    [bridge.c]
2026-10-16 Parse the GX430t's ^HH configuration dump and build printer setting commands
    zpl_hh_parse splits the real column layout (value in a 20-character field,
    then the name) with the dot-leader layout as fallback; zpl_hh_handshake now
    uses it, as the old dot-only scan failed on the GX430t's dump. Adds decoding
    of the editable settings, strict range-checked form parsing, and the ZPL
    command builder (~SD ^PR ^MT ^MM ^MN ^JS ^SZ ^PW ^LL ^ML ~TA ^LT ^LS ^MF
    ~JS ^JH, then ^JUS) and one-shot actions, host-tested against a real ^HH
    capture.
    [zpl_status.c, zpl_status.h]
2026-10-16 Cache the printer's ^HH configuration and send ZPL from the web server
    printer_link_refresh_config reads ^XA^HH^XZ under the link lock (bounded
    wait, 4 KB buffer: the GX430t's dump is 2522 bytes) and caches the parsed
    pairs with a timestamp; printer_link_send_zpl sends commands with the link
    held and drops the cache. The ^HH handshake fallback now shares the 4 KB
    buffer. probe_hs no longer hex-dumps the echoed ~HS on every scan when the
    line is a loopback; it logs that once.
    [printer_link.c, printer_link.h]
2026-10-16 Show the printer configuration and edit printer settings on the web pages
    GET /api/printer_config returns the cached ^HH pairs (re-read after 60 s or
    with ?refresh=1); the status page groups them. The settings page gets a
    printer settings form prefilled from ^HH (only changed values are sent, each
    range-checked server side, then ^JUS) and maintenance buttons: calibrate,
    feed, configuration label, counter resets, reload saved settings and factory
    defaults (which triggers a re-detect). New POSTs use the same-origin guard.
    max_uri_handlers raised to 16: the default 8 was already used up.
    [web.c]
2026-10-16 Discard a printer command left queued behind XOFF
    printer_link_send_zpl released the link with the command still queued when
    the printer held XOFF, so it could go out later ahead of a print job. Abort
    the queued output and report it instead.
2026-10-16 Advertise the model the printer reports instead of GK430t
    Detection now asks ~HI and keeps the model name (the GX430t answers
    GX430t-300dpi; the -300dpi suffix is dropped). The mDNS TXT records ty,
    product and usb_MDL start as a generic Zebra ZPL Printer and are updated
    once the printer answers. The status page and /api/status show the model.
2026-10-16 Show printer lengths and speeds in SI units
    The configuration table converts ^HH inches to mm, m or km, ips to mm/s
    and dot values to mm using the printer's own dots/mm from RESOLUTION,
    with the printer's text after each value. The settings form shows the
    speed choices in mm/s and each dot field's range and value in mm.
2026-10-16 Read the maximum label length from the printer's mm figure
    ^HH shows ^ML as "39.0IN 975MM". On the bench GX430t the mm figure is
    exact (^ML6000 at 12 dots/mm shows 500MM) and the inch figure is mm / 25
    (the same setting shows 20.0IN), so converting the inches with 25.4
    overstated the length by 1.6 %.
2026-10-16 Cope with ZPL printers other than the G-series
    From a compatibility review against Zebra's documentation:
    - Read device.languages after detection. A printer in EPL, CPCL or
    line-print mode gets no ^SC, ^HH or ~HI (line print would print them),
    later scans skip ~HS, and the web settings and actions report that the
    printer is not in a ZPL language. Model comes from SGD
    device.product_name when ~HI is not used.
    - A detected printer that stops answering stays detected: Zebra printers
    send no ~HS reply with paper or ribbon out or the head open. Each poll
    tries ~HS, then an SGD getvar. The status page shows "not answering for
    ..." and the LED follows. The bauds are scanned after 3 m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
    [main.c, printer_link.c, printer_link.h, settings.c, settings.h, web.c, zpl_status.c]
2026-10-16 Explain the printer's sensor, firmware and memory lines
    Sensor lines get plain names and their 0 to 100 scale, with a bar showing
    where the gap and label readings sit. Sensors the printer is not using with
    the current media, print method and mode are dimmed with the reason. The
    firmware arrow is dropped and RAM and flash read as KB with their drive
    letter. The printer's own text stays after each value.
2026-10-16 Join the strongest access point and keep the radio awake
    The default fast scan joined the first access point with the SSID; on a
    network with several, the bench board joined one at -90 dBm (SNR 6) and
    pages stalled mid-transfer until the link dropped and it rejoined at -31.
    Scan all channels and sort by signal. Modem sleep is off: the board is
    USB powered and sleep only delays replies.
    [wifi_prov.c]
2026-10-16 Show one value per configuration row
    The printer's own name and text move from small text after each value to
    the row's tooltip, and RAM and flash read as plain KB.
2026-10-16 Fix the status page script broken by an apostrophe in the tooltip hint
    The C string's \' reached the JavaScript as a bare quote and ended the
    string literal, so the status page script did not run. Reworded without
    the apostrophe.
    [web.c]
2026-10-16 Use the lid's logo mark on the web page and favicon
    The page drew the original thin mark while the case carries the bolder
    lid variant from make_logo.py; both now use zebserial-mark-lid.svg.
2026-10-16 Revert "Use the lid's logo mark on the web page and favicon"
    This reverts commit 6654d067d5f313e906f3c53a2826f48a13a64d0d.
    [web.c]
2026-10-16 Put the web page's striped logo on the lid
    The lid carried the bolder two-stripe variant. It now uses the striped
    mark (zebserial-mark-deboss.svg, the page's path at 1 unit = 1 mm) with
    every corner rounded to 0.62 mm: unrounded, its stripe ends and arc tips
    failed check_logo at 30 mm (18 corner hits; no stroke or gap under
    1.2 mm). Rounding leaves the inlay volume unchanged at 0.316 cm3, so no
    gap was filled or stroke dropped. All build gates pass. The print 3MFs
    are not re-sliced: the case is being reworked for the HW-044 board.
    [lid.stl, logo.stl, zebserial_case.scad]
2026-10-16 Rework the case for the HW-044 MAX3232 board
    The user now uses an HW-044 (32 x 29 PCB, female DB9, header at the rear
    centre, mounting holes at the rear corners) instead of the YL-97.
    - Board located by two tray pins through the rear-corner holes (2.0 in X,
    lens-shaped with 0.45 clearance in Y) and held by two lid corner pressers;
    the tray rear wall, 0.25 behind the PCB, replaces the backstop rib, and the
    side pressers go.
    - Leg-tail pockets off; a +-1.5 mm keep-out round the estimated tails is
    part of the ghosts, so check_tray enforces it.
    - XIAO turned 90 degrees on the DB9 body: USB-C out of the -X wall (away
    from the parallel port), USB end 0.2 from the inner wall, front edge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
    [coupon_lid.stl, coupon_tray.stl, lid.stl, logo.stl, tray.stl, zebserial_case.scad]
2026-10-16 Re-slice for the HW-044 case with the logo in the tray (case 1 h 15 min, 17.1 g + 0.3 g; coupon 50 min, 10.5 g)
    The slicing script now makes the logo a part of the tray object, since
    logo.stl shares the tray's coordinates.
    [zebserial_case.3mf, zebserial_coupon.3mf]
2026-10-16 Give the corner pins an X control of their own and locate every control hit
    The whole-board X move also hits the side walls, which are 0.2 from the
    PCB edge like the pins, so it did not show the pins working. A holes-only
    X move (ghost_mh_dx) now does. The README table names what each positive
    control actually hits, and the concerns list the pin engagement left when
    the unit hangs upside down.
    [zebserial_case.scad]
2026-10-16 Advertise the status page as the printer's Bonjour adminurl
    The Bonjour printing spec's adminurl TXT key gives the macOS print queue a
    Printer Website button that opens http://<hostname>.local/.
2026-10-16 Try a new Wi-Fi network for 30 s and go back to the saved one if it fails
    wifi_prov_join leaves for the new network about 1 s after the request,
    saves the credentials only once it gets an address there, and otherwise
    restores the saved network after 30 s. The state and the last disconnect
    reason (wrong password, network not found) are readable for the web page.
    Bench: a wrong password for the current network and a missing SSID both
    reverted to the saved network after about 35 s with the reason reported.
    The success path (joining a different real network) is not yet tested.
    [wifi_prov.c, wifi_prov.h]
2026-10-16 Split the web UI into Status, Printer and Bridge pages, and add Wi-Fi join
    - Navigation bar on every page. Status is read-only: printer and bridge
    tables, then the printer configuration.
    - Printer page: the printer's own settings grouped as on the status page,
    Send to printer, a notice after every action, Routine and Reset
    maintenance with the reset actions marked.
    - Bridge page: Wi-Fi (current network, scan on request, Join with
    fallback, Forget naming the setup network), network, and the serial
    link. /settings redirects to /printer.
    - One label and value wording per printer setting, sent from the firmware
    (var UI) and from /api/printer_config's new cfg object, so the status
    t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
    [web.c]
2026-10-16 Clear a partial format left by reset noise, and retry a lost first ~HS
    While this board resets, its TX pin floats until the UART starts, and the
    noise can leave the GX430t inside a ^ format. ~HS then reports a partial
    format (string 1 field h) and the printer ignores SGD until the format
    ends, so device.languages and comm.handshake came back empty and the
    language showed as unknown for the whole session.
    - zpl_hs_t gains partial_format; host test against the reply captured in
    that state. /api/status shows it.
    - At detection, a partial format with nothing queued is cancelled with
    ~JA (no print, unlike ^XZ), and ~HS is read again.
    - When the first ~HS is lost to the same noise but SGD ans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
    [printer_link.c, web.c, zpl_status.c, zpl_status.h]
2026-10-17 Name the Bonjour service after the printer model, saved across boots
    The macOS printer list shows the service instance name, so "ZebSerial
    (zebserial)" becomes "Zebra GX430t (zebserial)" once a printer has
    answered ~HI. The model is saved in NVS and used from boot, so the name
    does not change while the printer is off and the old name is never
    announced. The model is cut to 22 characters to keep the name inside
    the 63-byte DNS label limit.
2026-10-17 Advertise the product of the macOS Zebra ZPL driver
    macOS chooses the driver whose PPD *Product equals the Bonjour TXT
    product. "(Zebra GX430t)" matched nothing, so Add Printer offered
    Generic PostScript. The CUPS sample driver "Zebra ZPL Label Printer"
    has *Product "(ZPL Label Printer)", so that is sent now; the model
    stays in the service name, ty and usb_MDL.
2026-10-17 Drop the Bonjour note record, which macOS shows as Location
    The Bonjour printing spec defines note as the printer's location, so
    Add Printer filled Location with "ZebSerialWifi". Leaving it out leaves
    Location empty for the user to fill in.
2026-10-17 Read the printer language again from the poll when detection missed it
    A printer stuck on a format ignores SGD, so device.languages read at
    detection could fail and the language stayed unknown until the bridge
    rebooted. While it is unknown and ~HS shows nothing queued, each poll
    reads it again, for up to 20 polls (10 min). Tested with a build that
    skipped the read at boot: the first poll, 30 s later, read epl_zpl.
    [printer_link.c]
2026-10-17 Send the log to an iot_log receiver, configurable on the Bridge page
    Links the ESP-IDF port of esp-iot-log (git dependency, pinned to
    e6a5a22). Its redirect_esp_log option is not implemented in that port,
    so remote_log.c hooks esp_log_set_vprintf itself. The hook runs in
    whatever task logged, so it only formats into a static buffer and
    queues the line (12 KB ring, dropped when full or busy). One sender
    task makes every iot_log call and holds the queue until Wi-Fi is up,
    so the boot log arrives too.
    Bridge page, Remote log: on/off (on by default; nothing is sent until
    mDNS finds a receiver), level (errors, warnings, everything) and an
    optional IPv4 receiver address for unicast on networks th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
    [log_line.c, log_line.h, main.c, remote_log.c, remote_log.h, settings.c, settings.h]
2026-10-17 Add a README: printers, parts, wiring, the diode, clone chips and the handshake
2026-10-17 README: HW-044 clone and the male-DB9 version, and the pin 9 power wiring
2026-10-17 README: annotated photos of the bench set-up, the DB9 pads and the MAX3232; other XIAO boards
2026-10-17 Case revision 4: pin 9 wire path, more room behind and above the Dupont plug, no wings over the DB9 jack screws
    After the first HW-044 print. The board location and capture are unchanged.
    - Pin 9 power wire: a 2.0 mm keep-out from the pin 9 pad under the board to
    the rear edge, through a notch in a new backstop ledge, up into the 5V/GND
    zone.
    - Interior rear face 1.75 mm further back (dupont_rear_clr 1.5 plus room for
    the wire behind the PCB); a ledge keeps the 0.25 mm backstop below the PCB
    top. Case 40.4 x 33.5 x 31.2.
    - Wire-bend zone 14.2 x 5.2 (was 10.2 x 3.7), 5V/GND zone 1.5 mm deeper,
    D3/D5 channel 6.0 mm (was 5.0).
    - Lid front wall beside the DB9 body cut back to z 10.05 o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
    [coupon_lid.stl, coupon_tray.stl, lid.stl, logo.stl, tray.stl, zebserial_case.scad]
2026-10-17 Print README: the 3MFs predate case revision 4 and need re-slicing
2026-10-17 Assert the pin 9 wire passage leaves 0.4 mm round wire_d
    [zebserial_case.scad]
2026-10-17 Print a test label from the Printer page
    A border 1 mm in, mm rulers, the size and dpi as text, 1-4 dot lines, a
    solid band for dead dots, a 20 mm circle that shows a dpi mismatch, and
    Code 128 and QR codes. The size starts as the printer's print width and
    label length and can be edited, since a job's own ^PW and ^LL change
    them. Nothing is saved in the printer. Parts that do not fit a small
    label are left out.
    Host tests check the geometry stays inside the label (with controls for
    the checker), small and 1 m labels, field-data escaping and the error
    cases: 483 checks, 0 failures. Rendered with Labelary at 4x6/300 dpi
    and 50x25 mm/203 dpi. Built (ELF d3760492b), not yet run on the bridge.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
    [test_label.c, test_label.h, web.c]
2026-10-17 Re-slice the case and coupon for case revision 4
    Sliced with Bambu Studio's CLI from the revision 4 STLs (enclosure
    0ec4c89): case 1 h 16 min, 17.83 g + 0.29 g logo; coupon 51 min, 11.17 g.
    Removes the out-of-date note.
    [zebserial_case.3mf, zebserial_coupon.3mf]
2026-10-17 Firmware updates over the network, with rollback
    Two 1.875 MB OTA slots on the 4 MB flash (partitions.csv); nvs keeps its
    offset and size, so settings survive the change. The image is 1.07 MB.
    POST /update takes zebserial.bin as the raw body (the Bridge page
    uploads it with progress, or curl --data-binary), checks it is an
    ESP32-C6 image of this project, writes the other slot (esp_ota_end
    checks the SHA-256) and restarts. A new image confirms itself once it
    has a station IP after 15 s; with none by 180 s it rolls back, and a
    crash before confirming rolls back in the bootloader
    (CONFIG_BOOTLOADER_APP_ROLLBACK_ENABLE). The Bridge page can boot the
    other slot by hand. /api/status gains ota {ru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
    [partitions.csv]
2026-10-17 OTA status: only report the other slot's version if its whole image is valid
    A refused upload has already overwritten the start of the other slot, but its
    app header (the first sector) survives, so the status page still offered to go
    back to it. Verify the whole image once and cache the result until the slot
    is written again.
2026-10-17 Remote log: drop the duplicate level and timestamp, document unicast
    iot_log carries its own level and time, so each line read [WARN] W (108483)
    printer: ...; send it from the tag on. On the bench network mDNS found the
    receiver but no multicast copy arrived, while unicast to the same Mac did:
    say so in the README and troubleshooting.
2026-10-17 Remote log: join split lines, retry failed sends, pace the backlog
    The Wi-Fi driver prints "I (471) wifi:" and its text in two calls, which
    arrived as two lines; hold an unfinished line until its newline. The queued
    boot log went out as one burst: 59 of about 140 sends failed for want of
    Wi-Fi TX buffers, and after retries were added about 8 datagrams still went
    missing on the way. Retry a failed send up to 3 times, and wait a tick after
    each line: the next boot sent 112 lines and the Mac received all 112.
    [remote_log.c]
2026-10-17 Remote log: multicast only, no receiver address
    The fixed IPv4 receiver address worked around lost multicast, but the cause
    was the access point: with multicast-to-unicast it forwards the group only to
    clients whose IGMP report it has seen, and the receiver had not re-reported.
    The receiver now re-joins every 60 s (esp-iot-log), so the address setting,
    its form field and its NVS key are removed (the key is erased on the next
    save).
    [remote_log.c, remote_log.h, settings.c, settings.h, web.c]
2026-10-17 Case revision 5: XIAO turned 180 degrees, USB-C out of the +X wall
    The printed revision 4 almost fitted, but the RX diode at the XIAO's D3 pad
    hit the lid front wall. Turning the XIAO round puts D3/D5 on the rear edge,
    towards the Dupont plug, and 5V/GND on the front edge.
    - USB-C slot, tongue and overmould relief move to the +X wall.
    - -X end stop rib behind the antenna, tied to the -X side wall by a web.
    - Shield pad ring is whole again; the shield stop block sits between the
    D3 joints and a new 5V/GND corridor over the USB shell.
    - RX diode keep-out (DO-41, top-level parameters) standing beside the
    Dupont housing, with its leads; checked like the wire zones.
    - Front wall relief for t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
    [coupon_lid.stl, coupon_tray.stl, lid.stl, tray.stl, zebserial_case.scad]
2026-10-17 Enclosure README and renders for revision 5
    Revision 5 section, the XIAO turned round (USB-C out of +X), the -X stop rib
    and web, the 5V/GND corridor, the RX diode keep-out and the re-routed pin 9
    wire; controls table and wall-probe notes updated. New renders: the diode
    section and close-up, the XIAO with the lid off, the stop rib plan and the
    wire plan without keep-outs.
2026-10-17 Re-slice the case and coupon for case revision 5
    [zebserial_case.3mf, zebserial_coupon.3mf]
2026-10-17 Case revision 5: control the diode sweep and the bend-zone extension
    - ctl_diode_undercut: a lid block under the diode body, outside every
    keep-out; check_lid stays clear, check_lid_path must hit. It is the
    positive control for sweeping the diode.
    - The wire zones' extension of the bend zone (X -9 to the corridor) moves
    with ghost_dupont_d, so the Dupont controls exercise it; -Y 1 now also
    hits the shield stop block.
    - README: the diode checks prove clearance to the case only, not to the
    housing or the XIAO; 97 controls.
    The STLs and renders are unchanged, so the revision 5 slices stand.
    [zebserial_case.scad]
2026-10-17 Do not keep a sleeping printer awake: poll it only while its status is wanted
    Read power.energy_star.enable and power.sleep.enable at detection. When
    either is on, the 30 s ~HS poll stops; the status is read only after a
    Status page or /api/status request, at most every 30 s, with a second
    try 1 s later in case the first command only woke the printer.
    /api/status and the Status page show whether the printer sleeps.
2026-10-17 Sleeping printer: keep finding a silent one, no LED flash on wake, review fixes
    - A printer that sleeps but stopped answering is polled on the timer as
    before, so one switched off, reset to another baud or replaced is
    still found and rescanned.
    - The first missed probe at a printer that sleeps is not published, so
    the LED does not flash 'no printer' each time it is woken.
    - Output held by XOFF backs off for 10 s on both paths.
    - The Status page stops asking while its tab is hidden.
    - The status is read once after each job.
    [bridge.c, printer_link.c, web.c]
2026-10-17 Act on an external review: baud cap at boot, Wi-Fi join, rlog status, upload retry
    - The saved target baud applied at boot no longer counts as a change, so
    it does not wipe the learned baud cap on every boot (any target other
    than 115200 did).
    - A Wi-Fi join that fails is no longer reported as reason 8, the
    disconnect from the old network; and the old network gets the whole
    60 s fallback window back after a failed trial, not what was left.
    - The remote log status shown by /api/status comes from values the
    sender task caches: iot_log is not thread safe, and the web task
    could call it while the sender restarted it.
    - The firmware Upload button comes back after a refused or failed u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
    [printer_link.c, remote_log.c, web.c, wifi_prov.c]
2026-10-17 Printer settings: media detection as ^MNA, serial shown once, lengths in mm
    - SENSOR SELECT on the G-series is media auto-detect, ^MNA (GK420d user
    guide, ZPL configuration cross-reference), not ^JS: it reads AUTO or
    MANUAL, and MANUAL (the bench GX430t now) was not understood. It is now
    'Media type detection' (Automatic or Fixed) next to Media type; choosing
    Automatic sends ^MNA, Fixed sends the media type.
    - The Status page shows the serial settings once, in the Serial link row,
    instead of again under Communications.
    - Lengths on the Printer page are typed in mm (to 0.01 mm, which gives
    the same dot count back), with the dots alongside; the Status page shows
    mm first.
    [web.c, zpl_status.c]
2026-10-17 Say what the counter reset buttons reset
    They are now 'Zero user counter 1/2 (now 190.7 km)', and the confirmation
    says the counter measures media printed since it was last zeroed and that
    total printed and printhead usage are not changed. The Status page calls
    them User counter 1 and 2.
    [web.c]
2026-10-17 Counter reset buttons: say what the counters are, not their reading
    The confirmation now explains that user counters 1 and 2 are the
    printer's two counters of printed media that can be zeroed by hand (for a
    roll or a job), and that totals and printhead usage are kept. The reading
    is left out of the button.
2026-10-18 Warn when the chip gets too hot
    Read the ESP32-C6's temperature sensor every 30 s, show it on the Status
    page and in /api/status, and log one warning at 85 °C on the die (clears
    below 80 °C). About 56 °C is normal in the case; the datasheet gives no
    die limit, and the MAX3232 module and printed case overheat before the
    chip's 105 °C ambient rating.
    [main.c, temp_alarm.c, temp_alarm.h, temp_mon.c, temp_mon.h, web.c]
2026-10-18 Papercuts log: chip temperature work
2026-10-18 Wi-Fi: leave a link that gives no address, and skip access points below -85 dBm
    A wrong-password join on this WPA3 network twice left the bridge
    unreachable until a power cycle. On the way back the near access point
    refused for a moment (a PMF comeback), the driver joined the next one,
    the far access point at -92 dBm, and the link stayed associated without
    an IPv4 address. Retries only follow a disconnect, so nothing retried.
    - 20 s associated without IPv4: disconnect, so the normal retry scans
    again. Bench check with DHCP held off: it left at 20 s and had an
    address 6 s later.
    - Access points weaker than -85 dBm are skipped; when none is stronger
    (reason 212) any signal is taken unti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
    [wifi_prov.c]
2026-10-31 Convert mm with the true 300/600 dpi, not Zebra's rounded 12/24 dots per mm
    The printer reports a 300 dpi head as 12 dots/mm, but it is 11.81. Sizes
    typed in mm on the printer form and test label now print at that size
    (20 mm is 236 dots, not 240), and a 4 x 6 inch label shows as
    101.6 x 152.4 mm. New zpl_units.h with host tests from the inch definition.
    The ^HH maximum length mm figure stays at the printer's rounded dots/mm.
2026-10-31 ^HH: read right-aligned values such as a maximum length under 10 inches
    A GX430t shows ^ML600 as " 2.0IN 50MM": the value starts in the third
    column, not the second, so the fixed-column split rejected the line and the
    setting vanished from the printer page (59 settings instead of 60). The
    value may now start anywhere before the name column. Test from the line
    captured on 2026-10-31.
    [zpl_status.c]
2026-10-31 Test label: 0-4 mm scales from each side edge, to measure how far the print is off centre
    Ticks every 0.5 mm in the top corners, numbered at 2 and 4 mm, 3 dots
    wide (thinner lines along the feed broke up on silver PET). Ticks that
    miss the label print on the backing, so both edges can be read; the
    Printer page says how to turn the two readings into a Left Position
    change. The top ruler now stops 1 mm short of the right-hand scale.
    The test label keeps sending its own ^PW, as Label LIVE and drivers do,
    so it shows what real jobs get.
    [test_label.c, test_label.h, web.c]
2026-10-31 POST /pstprnt: print the request body, as Zebra's network printers do
    Label pages saved on a computer post ZPL to http://<printer>/pstprnt.
    The bridge now takes such a job the way it takes a port 9100 client: it
    holds the printer link, counts in the same statistics and streams the body
    to the UART in 1 KB pieces, so a large bitmap label is never buffered
    whole. Open to any origin (Access-Control-Allow-Origin: *, no Host check),
    which is no more than port 9100 already allows; refused on the setup AP.
    The web server waits for the job, so a printer that holds XOFF for 30 s
    has the rest dropped (504) and a link busy for 15 s gives 503.
2026-10-31 Cable flag label page, and /pstprnt in the README
    tools/cable-labels.html prints 60 x 20 mm flag labels through the bridge's
    /pstprnt: the same text on both ends, the same way up, with a blank wrap
    zone in the middle. Text shrinks to fit (DIN Condensed Bold by default;
    optionally the same size on every label), and each label goes as a 1-bit
    ^GFA image with ZPL's ASCII compression, about 4 KB instead of 42 KB.
    The compression round-trips 60 random bitmaps through a decoder written
    from the ZPL manual. Styles and icons are from the Label Printer page.
2026-10-31 Cable page and README: a Mac browser needs Local Network access to reach the bridge
2026-10-31 Cable page: set the cable diameter, and show the wrap zone worked out from it
    The wrap zone is pi x diameter plus 1 mm so the ends meet without pulling.
    The Layout section shows the result and the room left for text at each
    end, the preview labels the wrap with its width, and a cable too thick for
    the label says so. A saved wrap zone from before becomes the matching
    diameter.
2026-10-31 README for a public repo: MIT licence, maturity, accurate rollback and /pstprnt wording
    - MIT LICENSE, and a Licence section.
    - First line: printers with a serial port but no network connection.
    - A short note on maturity and what a build needs.
    - /pstprnt: say what it does open (a web page you visit can print and
    change printer settings) rather than "nothing new".
    - OTA: the new firmware is kept after 15 s with a Wi-Fi address; only no
    address in 180 s, or a crash before then, goes back.
    - Language retry is about 10 minutes, not a few; GK420 and GX420 (there is
    no GK430); unplug from the printer before connecting USB.
    - Papercuts: no access point address or machine names.
2026-10-31 OpenSpec: project context and the enclosure spec, as built (revision 5)
    openspec/config.yaml holds the project context: purpose, hardware, layout,
    constraints, quality gates and conventions. The enclosure spec says which
    SCAD parameters describe the RS-232 module, the XIAO and the case, what was
    measured and what was borrowed, and how to regenerate and check the STLs
    for a different module. The layout was written by hand to match what
    openspec init 1.16 creates (config.yaml, specs/, changes/archive/).
2026-10-31 OpenSpec: slicing-and-printing spec for the Bambu Studio CLI projects in print/
2026-10-31 OpenSpec: firmware and cable-label-page specs, as built
    Specs for printer-link, print-bridge, http-print, web-ui,
    wifi-provisioning, device-settings, discovery, ota-updates, remote-log,
    chip-temperature and cable-label-page. Each requirement cites the source
    file and function or constant. The project context now records the 21 of
    24 HTTP handler slots in use and the single server task.
2026-10-31 OpenSpec: one owner per behaviour, and citations checked
    - Pin detection is specified in printer-link only; device-settings keeps
    the pins key and points there.
    - Wi-Fi join and forget are in wifi-provisioning only (with the too-long
    case); the Bridge page Firmware section is in ota-updates only; the
    Bridge page reboot rule is in web-ui only.
    - The test label edge-scale scenario now follows test_label.c.
    - Citation paths fixed (enclosure scripts, the iot_log component).
    - Project context: where power save is set, generated files, and no
    script yet for node --check.
2026-10-31 OpenSpec: act on the Fable review
    - Known deviations: a list under Notes for each place the code does not
    yet meet a requirement (OPTIONS on /pstprnt, the 10 mm test label, mm
    shown with the rounded pitch, the cable page Address field), and the
    convention in config.yaml with a rules block for proposals, specs,
    design and tasks.
    - printer_link_set_pins() is an unused API, not specified behaviour.
    - Corrections: the bridge_send_job drain stall, the /update 500 cases,
    the /api/printer_config 500, the ^GFA repeat order, the form decoding
    citation.
    - Coverage: /save on any network, the captive DNS bind retry, the remote
    log queue allocation, the mDNS name lengths, and the cable page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
2026-10-31 OpenSpec: act on the enclosure review
    - Scope the parameter rule to dimensions that depend on the module, the
    XIAO or the print process; the gender changer; negative pcb_front_y.
    - A failed assert stops build.sh at the first STL export after it has
    deleted out/ and renders/, with no FAIL line; say so, and how to
    restore them. wallprobe's 1.2 mm is its own --min default.
    - Component-side parts are not modelled: the heights that collide
    unseen, a measurement item, and fl_bot other than 0 untested.
    - More fixed values a module change must revisit; joint-zone extents;
    the Y capture by the USB slot sides.
    - Fit coupons owned by the enclosure spec (board, DB9 and XIAO, with the
    fit des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
2026-10-31 Fix the four known deviations, and the review's README and comment corrections
    - /pstprnt answers an OPTIONS preflight with 204 and the CORS headers,
    including Access-Control-Allow-Private-Network, so a page sending JSON
    or its own headers can print.
    - Test label: the minimum is 10 mm at the true pitch (118 dots at 300 dpi,
    not 120), so a 10 mm label no longer gets a 500. Host test added.
    - Status page lengths use the true pitch, like the Printer form.
    - Cable page: the Address field keeps what is typed, even empty, and goes
    back to zebserial.local only when left empty.
    - /save's success page links the saved hostname. OTA_CONFIRM_DEADLINE_S
    moves to ota.h and the Bridge page uses i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
    [dns_hijack.c, ota.c, ota.h, test_label.c, web.c]
2026-10-31 OpenSpec: archive fix-known-deviations
    The first change through the spec workflow. http-print now requires the
    OPTIONS preflight answer, web-ui the same mm on the Status page and the
    Printer form (and why the printer's own MAXIMUM LENGTH label reads 1.6 %
    short at 300 dpi), cable-label-page an Address field that keeps what is
    typed. Their Known deviations lists are empty. Bench-checked on ee4f220:
    preflight 204 with the CORS and private-network headers, a JSON POST from
    Chrome printed, Status and Printer pages both show 20.1 mm and 50.8 mm,
    and a 10 x 10 mm test label builds (118 dots) instead of a 500.
2026-10-31 CI: GitHub Actions for OpenSpec, host tests, firmware build, page JavaScript and enclosure gates, and AGENTS.md
    tools/check_page_js.py runs node --check on the scripts in web.c and the cable label page, which was done by hand.
2026-10-31 Enclosure: fail the build on ZEBCASE WARNING echoes
    - The SCAD's only informational warning, the front-edge joints over the
    jack screw hardware, now echoes "ZEBCASE NOTE (check)". Every
    remaining "ZEBCASE WARNING" means wrong geometry. Echo text only: the
    STLs and renders are unchanged.
    - build.sh evaluates the model once (echo export, with the extra -D
    overrides) and prints each ZEBCASE WARNING as a FAIL line; notes are
    printed and pass. controls.sh counts a run that echoes one as an error.
    - Positive controls: lip_x=10, lip_ds_clr=5, front_rest_min=10,
    max_above=20, and leg_pocket_on=true with leg_clr=3 each fail the
    build with their warning; controls.sh under lip_x=10 fails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
    [zebserial_case.scad]
2026-10-31 CI: keep the IDF caches inside the container's view of the workspace, let paths-filter read pull requests, and say when the enclosure gates run
2026-10-31 OpenSpec: fill the gaps a clean-room rebuild would have to guess
    - Fix today's contradictions: 22 HTTP handlers (/pstprnt has POST and
    OPTIONS), the cable page's simple-request reason, and one statement of
    what build.sh does when the top exceeds max_above (edited in the SCAD:
    stops at the first STL export; as an override: 9 FAIL lines).
    - web-ui Notes: the ^HH to Printer form decode table with every text map,
    number format and range, the resolution line, the rule for leaving out
    choices, the Status page groups, friendly names, dimming rules, sensor
    bar and value formatting, every form field name, and the /api/status
    value formats.
    - The station states, stored string lengths, th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
2026-10-31 Printer form: no ^MN when the media type is unknown
    Setting media detection to Fixed while the printer had reported no media
    type the bridge knows built "^MN" followed by a zero byte, which cut the
    command string off before ^XZ and the save. Now ^MN<letter> is sent only
    with a known letter. Found by the clean-room spec gap audit; host test and
    web-ui scenario added.
    [zpl_status.c]
2026-10-31 OpenSpec: say the 3V3 pull-up room is optional, point the enclosure gates at their scripts, record the Bambu Studio and OpenSCAD versions as observed, and specify the cable page's active row and ink 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
2026-10-31 OpenSpec: correct the task priority order, the boot restart list and two examples, and confirm the UART IRAM interrupt note against the driver
2026-10-31 Logo script: say the case debosses the deboss SVG and the lid SVG is unused; OpenSpec config names the current main
